incom8134-web/Kiro_wiring/images/ac.png

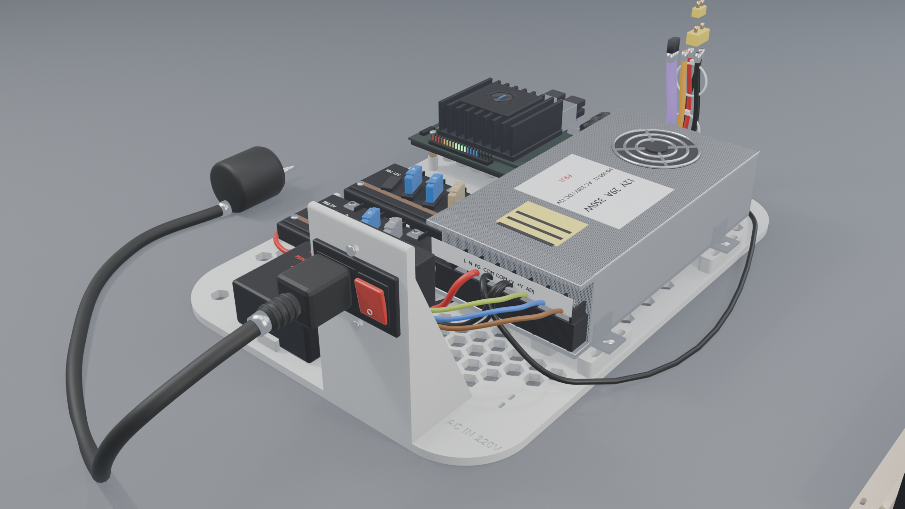
images/ac.png
