incom8134-web/Kiro_wiring/images/close.png

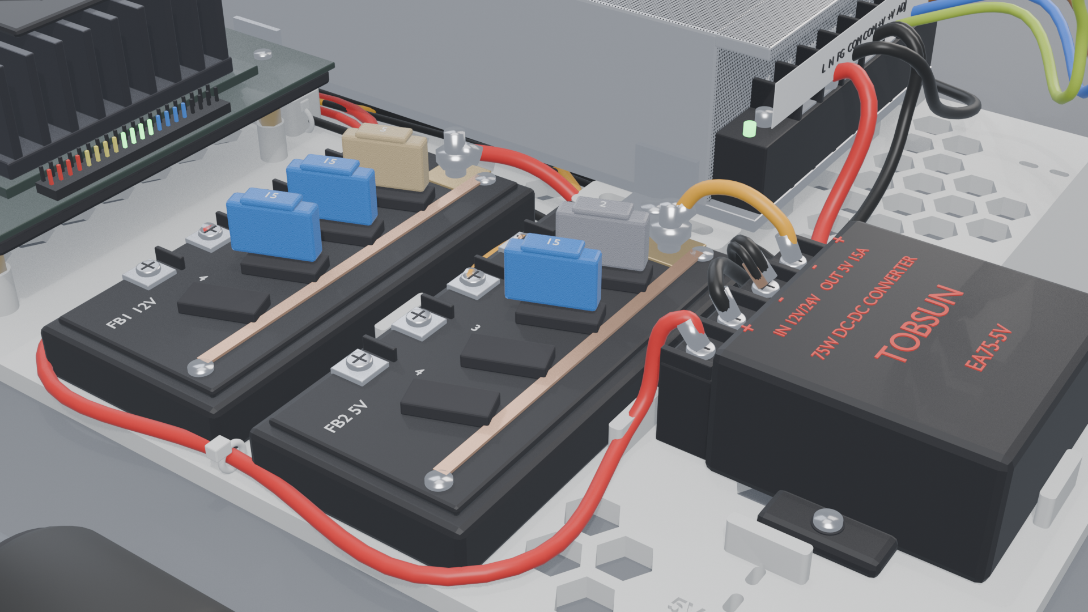
images/close.png
