incom8134-web/Kiro_wiring/images/Gemini_Generated_Image_z3li0kz3li0kz3li.png

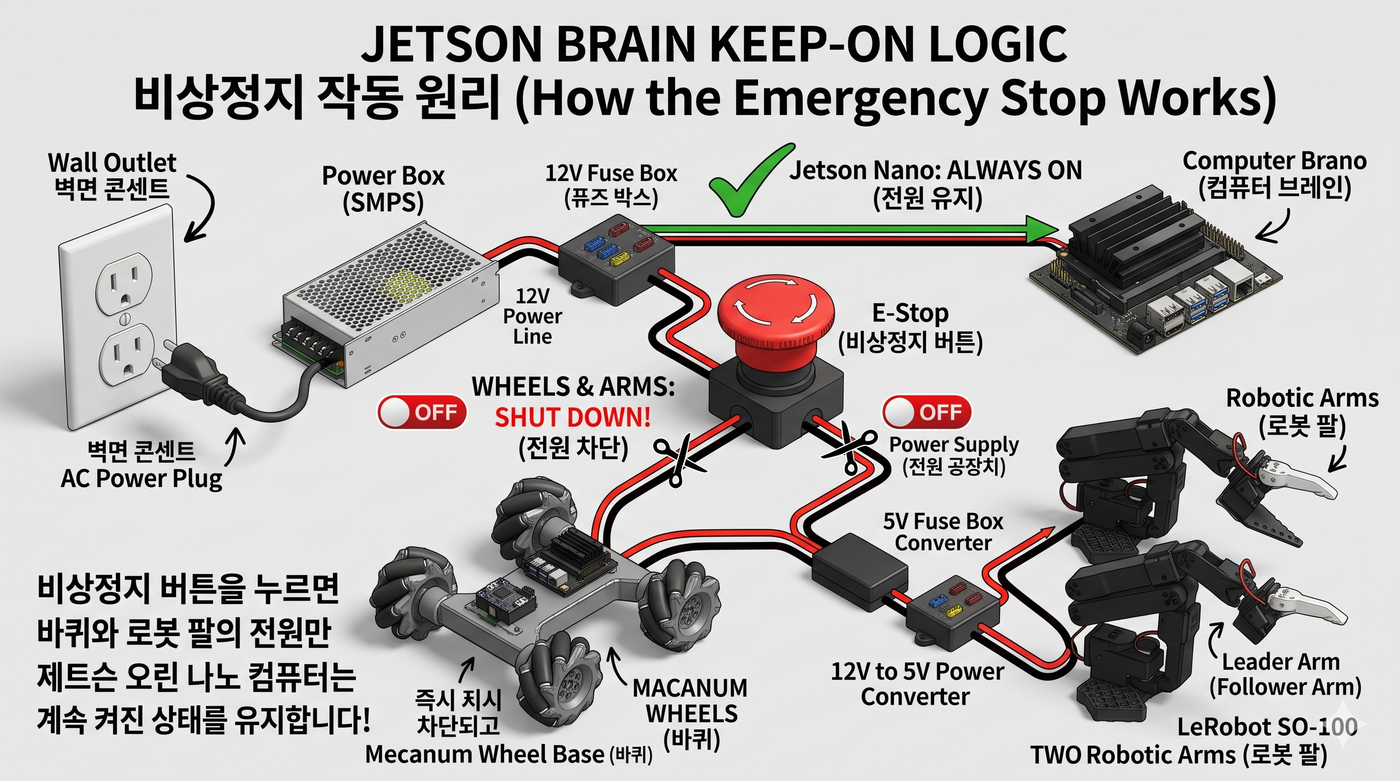
images/Gemini_Generated_Image_z3li0kz3li0kz3li.png
