incom8134-web/Kiro_wiring/images/hub.png

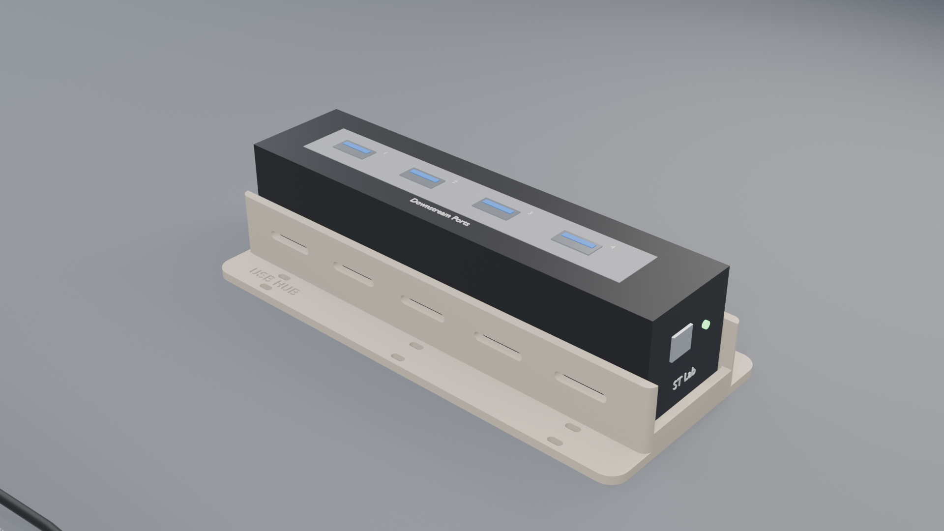
images/hub.png
