incom8134-web/Kiro_wiring/images/kiro-emergency-stop.png

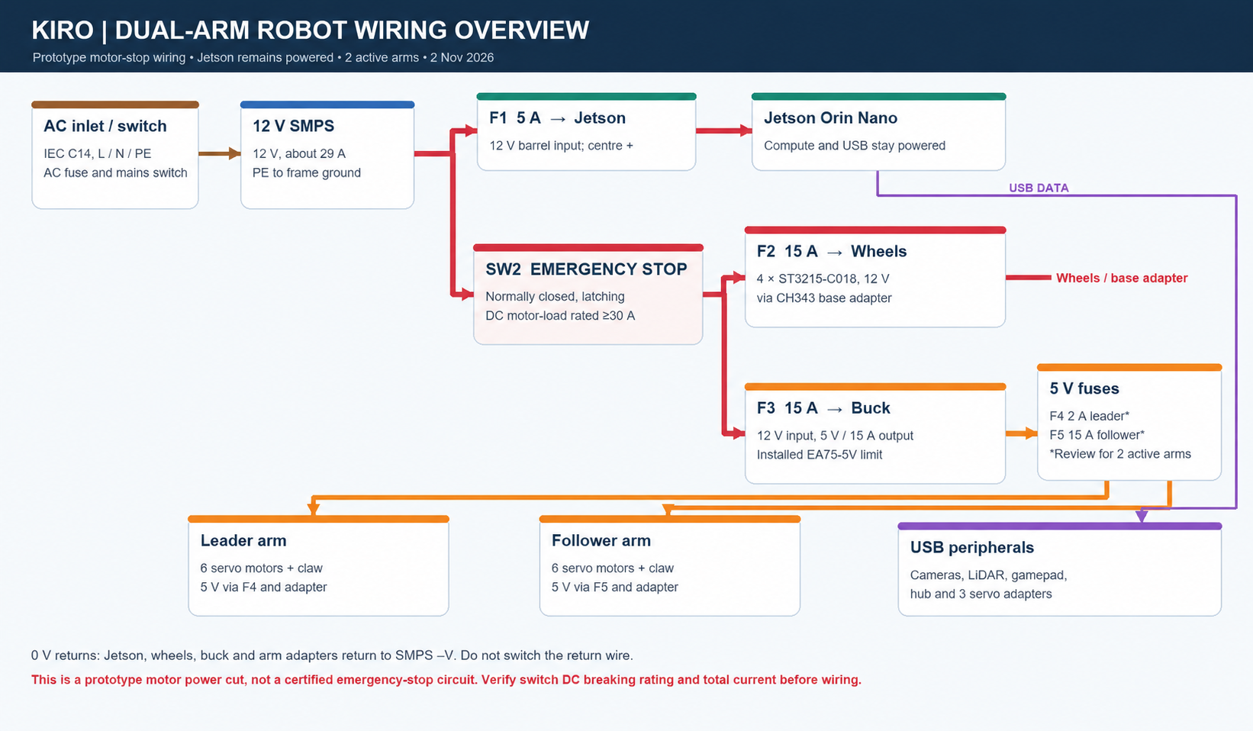
images/kiro-emergency-stop.png
