incom8134-web/Kiro_wiring/images/side.png

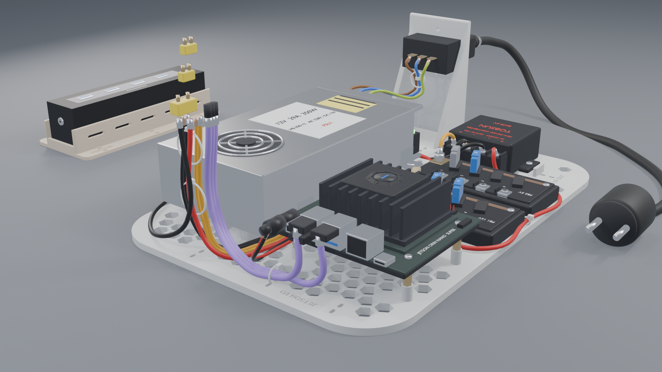
images/side.png
