incom8134-web/Kiro_wiring/images/top.png

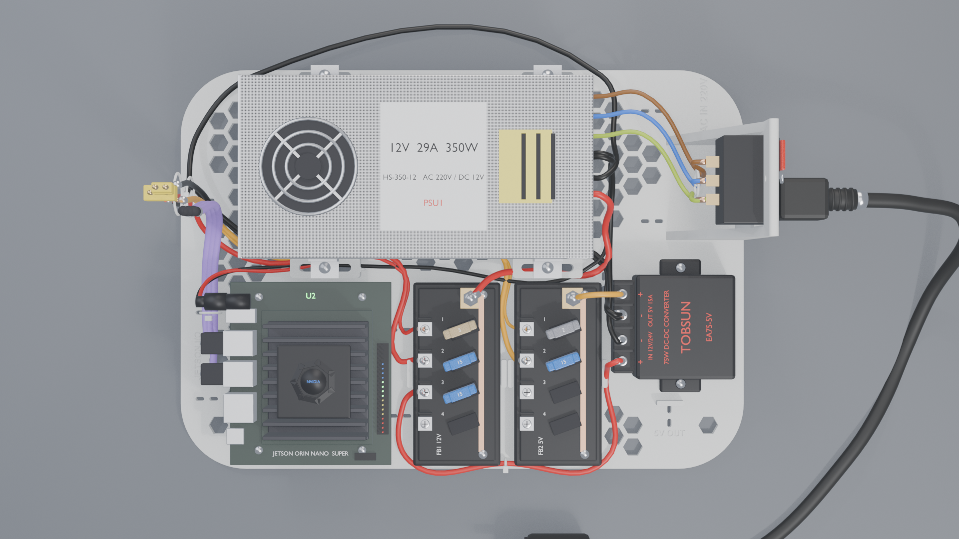
images/top.png
