incom8134-web/Kiro_wiring/kiro-wiring-2/exports/KIRO_배선도V2_BOM_261111.csv

Qty | References | Value | Library symbol | Status
1 | BT1 | LiFePO4 12.8V 45Ah (GEN) | Device:Battery | GENERIC placeholder - replace with real part
3 | C21 C22 C60 | 100nF | Device:C | specified
2 | C61 C62 | 1uF | Device:C | specified
1 | D1 | 5.0SMDJ18CA (GEN) | Device:D_TVS | GENERIC placeholder - replace with real part
1 | D2 | SMBJ18CA (verify) | Device:D_TVS | verify before purchase
2 | D60 D62 | BAT54 | Device:D_Schottky | specified
1 | D63 | 15V zener | Device:D_Zener | specified
1 | F1 | F_MAIN 40A ANL / 8AWG (GEN) | Device:Fuse | GENERIC placeholder - replace with real part
1 | F2 | F_CHG 15A (GEN) | Device:Fuse | GENERIC placeholder - replace with real part
1 | F3 | F_JETSON 5A / 18AWG | Device:Fuse | specified
1 | F4 | F_HUB 3A / 18AWG | Device:Fuse | specified
1 | F5 | F_CTRL 2A / 20AWG | Device:Fuse | specified
1 | F6 | F_DRIVE 20A / 12AWG | Device:Fuse | specified
1 | F7 | F_ARM_IN 10A / 14AWG | Device:Fuse | specified
1 | F8 | F_LEADER 2A / 20AWG | Device:Fuse | specified
1 | F9 | F_FOLLOWER 15A / 14AWG | Device:Fuse | specified
1 | F10 | F_BEACON 2A / 20AWG (GEN) | Device:Fuse | GENERIC placeholder - replace with real part
1 | J1 | J_BATT Anderson SB50 (GEN) | Connector_Generic:Conn_01x02 | GENERIC placeholder - replace with real part
1 | J2 | J_CHG XT60 charger inlet (GEN) | Connector_Generic:Conn_01x02 | GENERIC placeholder - replace with real part
1 | J60 | J_BEACON 2-pin 5A (GEN) | Connector_Generic:Conn_01x02 | GENERIC placeholder - replace with real part
1 | K1 | K1 12V DC contactor 80A + AUX NO (GEN) | KIRO_V2:Contactor_1NO_AuxNO | GENERIC placeholder - replace with real part
1 | LA1 | Red 12V LED beacon 5W (GEN) | Device:Lamp | GENERIC placeholder - replace with real part
1 | M31 | ST3215-C018 FR ID7 | KIRO_V2:Servo_ST3215 | specified
1 | M32 | ST3215-C018 FL ID8 | KIRO_V2:Servo_ST3215 | specified
1 | M33 | ST3215-C018 RR ID9 | KIRO_V2:Servo_ST3215 | specified
1 | M34 | ST3215-C018 RL ID10 | KIRO_V2:Servo_ST3215 | specified
1 | M40 | LEADER 6x STS3215 (torque off) | KIRO_V2:ServoChain_STS3215_x6 | specified
1 | M41 | FOLLOWER 6x STS3215 7.4V (GEN) | KIRO_V2:ServoChain_STS3215_x6 | GENERIC placeholder - replace with real part
1 | NT1 | carrier GND = J16 return | Device:NetTie_2 | specified
1 | Q1 | IRLZ44N (GEN) | Device:Q_NMOS | GENERIC placeholder - replace with real part
1 | Q2 | BSS138 | Transistor_FET:BSS138 | specified
2 | R1 R66 | 4k7 | Device:R | specified
1 | R21 | 1k | Device:R | specified
3 | R22 R23 R61 | 100R | Device:R | specified
3 | R24 R25 R60 | 10k | Device:R | specified
3 | R62 R63 R65 | 100k | Device:R | specified
1 | R64 | 220R | Device:R | specified
1 | S1 | 22mm mushroom twist-release 1NC (GEN) | KIRO_V2:EStop_Mushroom_NC | GENERIC placeholder - replace with real part
1 | SW1 | SW_MAIN 100A disconnect (GEN) | Switch:SW_SPST | GENERIC placeholder - replace with real part
1 | SW2 | START momentary NO | Switch:SW_Push | specified
1 | TP1 | TP_DRIVE_POWER | Connector:TestPoint | specified
1 | TP2 | TP_ARM_POWER | Connector:TestPoint | specified
1 | TP60 | TP_BEACON_ENABLE | Connector:TestPoint | specified
1 | TP61 | TP_BEACON_OUT | Connector:TestPoint | specified
1 | TP70 | TP_BATTERY_RAW | Connector:TestPoint | specified
1 | TP71 | TP_POWER_GND | Connector:TestPoint | specified
1 | TP72 | TP_COMPUTE_POWER | Connector:TestPoint | specified
1 | TP73 | TP_CTRL_12V | Connector:TestPoint | specified
1 | TP74 | TP_12V_AFTER_CONTACTOR | Connector:TestPoint | specified
1 | TP75 | TP_REGULATED_12V | Connector:TestPoint | specified
1 | TP76 | TP_ARM_LEADER_5V | Connector:TestPoint | specified
1 | TP77 | TP_ARM_FOLLOWER_5V | Connector:TestPoint | specified
1 | TP78 | TP_BEACON_12V | Connector:TestPoint | specified
1 | TP79 | TP_USB_SENSOR_5V | Connector:TestPoint | specified
1 | TP80 | TP_LOGIC_3V3 | Connector:TestPoint | specified
1 | TP81 | TP_ESTOP_OK_N | Connector:TestPoint | specified
1 | U1 | Ideal-diode LM74700 module 10A (GEN) | KIRO_V2:RevPol_IdealDiode | GENERIC placeholder - replace with real part
1 | U2 | HUB PSU 12V->5V 5A buck (GEN) | KIRO_V2:DCDC_Module | GENERIC placeholder - replace with real part
1 | U3 | REG12 12V 15A buck-boost (GEN) | KIRO_V2:DCDC_Module | GENERIC placeholder - replace with real part
1 | U4 | TOBSUN EA75-5V (8-40V in, 5V 15A) | KIRO_V2:DCDC_Module | specified
2 | U5 U61 | PC817 | Isolator:PC817 | specified
1 | U20 | Jetson Orin Nano Super Dev Kit 8GB (P3768 carrier) | KIRO_V2:Jetson_OrinNano_Super_DevKit | specified
3 | U21 U22 U60 | 74LVC1G17 | 74xGxx:74LVC1G17 | specified
1 | U30 | Bus Servo Adapter (A) CH343 - WHEELS | KIRO_V2:BusServoAdapter_A_CH343 | specified
1 | U40 | Bus Servo Adapter (A) CH343 - LEADER | KIRO_V2:BusServoAdapter_A_CH343 | specified
1 | U41 | Bus Servo Adapter (A) CH343 - FOLLOWER | KIRO_V2:BusServoAdapter_A_CH343 | specified
1 | U50 | Powered 4-port USB3 hub 5V 4A (GEN) | KIRO_V2:USB_Hub_Powered | GENERIC placeholder - replace with real part
1 | U51 | Orbbec Gemini 335 (head) | KIRO_V2:USB_Device | specified
1 | U52 | Suyin HD webcam 1e45:8022 (wrist) | KIRO_V2:USB_Device | specified
1 | U53 | Slamtec RPLIDAR C1 + CP2102N | KIRO_V2:USB_Device | specified
