incom8134-web/Kiro_wiring/3d_models/assembly.step

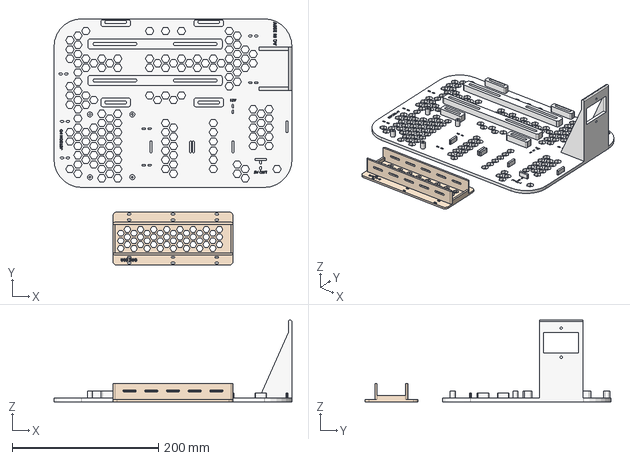
[picture p9: CAD file, 2026-10-26]
3d_models/assembly.step
326.0 x 337.5 x 112.0 mm
base_plate
usb_hub_tray
