incom8134-web/Kiro_wiring/3d_models/base_plate_left.step

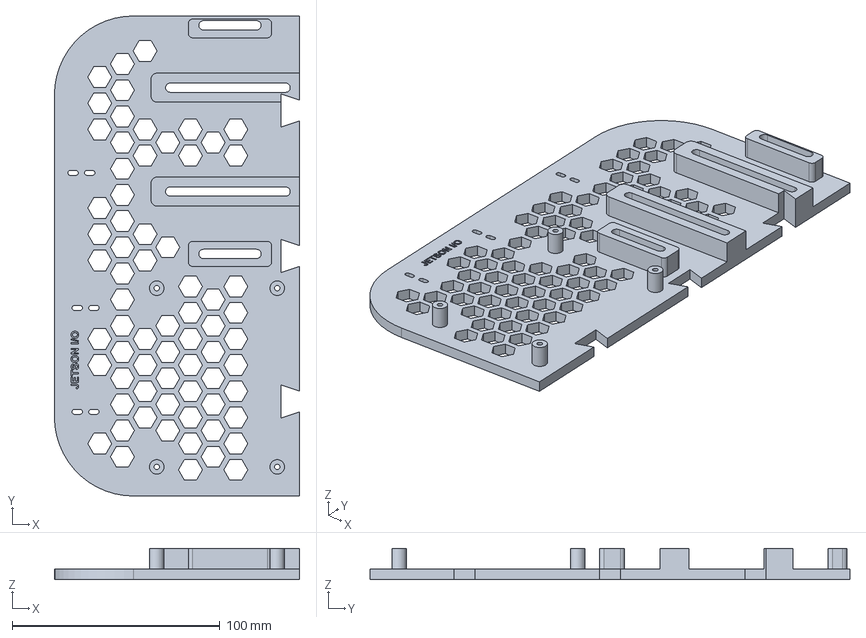
[picture p10: CAD file, 2026-10-26]
3d_models/base_plate_left.step
118.0 x 231.0 x 15.0 mm
