incom8134-web/Kiro_wiring/3d_models/usb_hub_tray.step

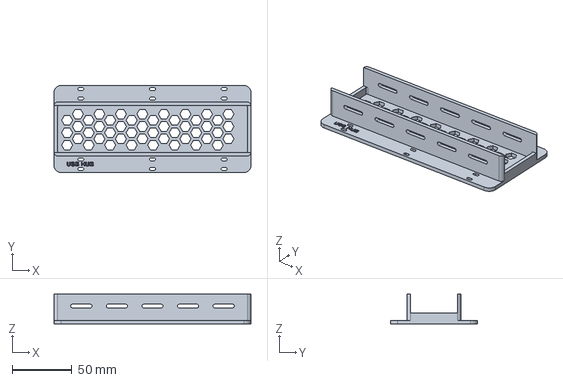
[picture p11: CAD file, 2026-10-26]
3d_models/usb_hub_tray.step
165.0 x 73.0 x 25.0 mm
