incom8134-web/Kiro_wiring/3d_models/base_plate_right.step

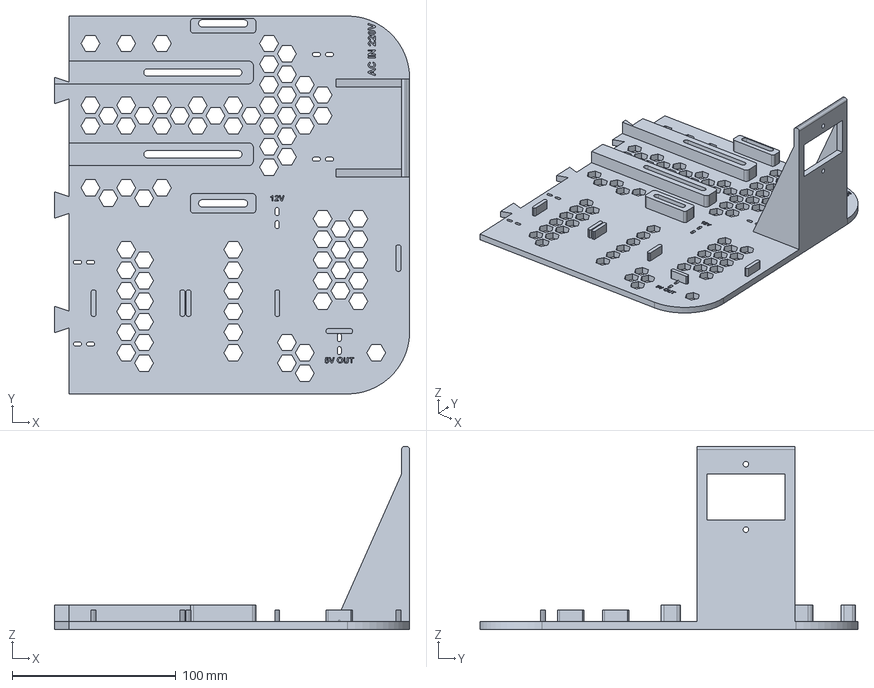
[picture p12: CAD file, 2026-10-26]
3d_models/base_plate_right.step
217.2 x 231.0 x 112.0 mm
