incom8134-web/Kiro_wiring/3d_models/base_plate.step

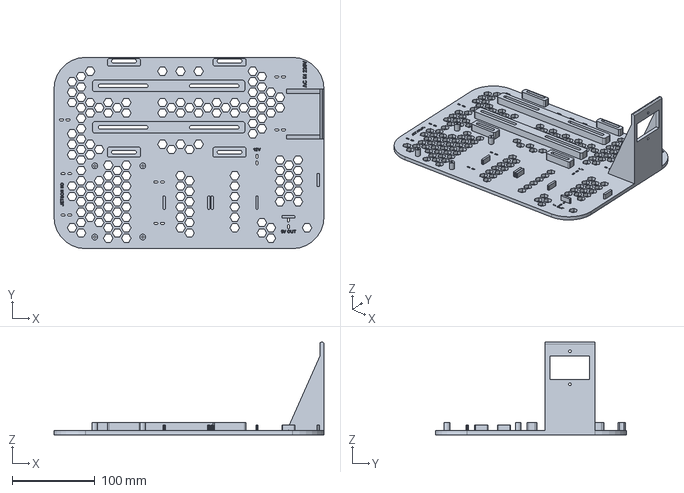
[picture p13: CAD file, 2026-10-26]
3d_models/base_plate.step
326.0 x 231.0 x 112.0 mm
