incom8134-web/Kiro_wiring/(list of files, cad)

Other CAD files:
3d_models/KIRO_power_plate.blend
3d_models/assembly.obj
3d_models/print_files/base_plate_left.3mf
3d_models/print_files/base_plate_right.3mf
3d_models/print_files/usb_hub_tray.3mf
