incom8134-web/Kiro_wiring/kiro-wiring-2/docs/KIRO_배선도V2_엔지니어링문서_261111.md

# KIRO Wiring V2 — Engineering Document (2026-11-11, rev B: generic parts)

## 0. Summary

| Item | Status |
|---|---|
| KiCad project | `kiro_wiring_v2/kiro_wiring_v2/` — root + 9 sub-sheets = **10 sheets**, **84 parts**, **74 nets** |
| KiCad ERC (10.0.7) | **0 errors / 0 warnings** |
| Connection checks | 0 unconnected pins, floating wires, orphan labels, shorted nets, symbol overlaps (all 10 sheets) |
| Cross-sheet nets | All 21 verified joined in the exported netlist |
| Visual check | All 10 sheets rendered and inspected; no overlapping or clipped text |
| V1 files | **Unchanged** (read only) |
| Part data | Real data unavailable → **18 parts are GENERIC placeholders marked `(GEN)`** on the schematic and BOM (section 15) |

Key design decisions:

1. **E-stop is a pure hard-wired self-holding loop:** mushroom NC → START (NO) ∥ K1 AUX (NO) → K1 coil. Works without software, drops out on a broken wire, no automatic restart.
2. **Jetson is upstream of K1** (COMPUTE_POWER) so it keeps running for logging and clean shutdown after an E-stop.
3. **No direct load on J12 GPIO.** NVIDIA carrier spec: J12 signals pass through TI TXB0108 translators, ±20 µA drive, pull-ups/pull-downs must be > 50 kΩ. Every GPIO uses a 74LVC1G17 buffer.
4. **Warning light fails to the warning state.** Light is ON whenever K1 is closed; it turns OFF only while the Jetson sends a ≥ 100 Hz pulse (charge-pump watchdog). Frozen, booting or crashed Jetson → light ON.
5. **REGULATED_12V is required** (LiFePO4 full charge 14.6 V > ST3215 limit 12.6 V).

---

## 1. Hardware inventory

| # | Item | Model used in V2 | Source |
|---|---|---|---|
| 1 | Battery | **LiFePO4 4S 12.8 V 45 Ah, BMS 50 A cont / 100 A peak (GEN)** | generic |
| 2 | Computer | NVIDIA Jetson Orin Nano Super Dev Kit 8 GB | V1 doc |
| 3 | Carrier | NVIDIA reference carrier (P3768): J16 DC, J12 header, J6/J7 USB | V1 doc + NVIDIA spec |
| 4 | Wheel servos | 4 × ST3215-C018 (FR 7, FL 8, RR 9, RL 10) | V1 measured |
| 5–7 | Servo adapters | 3 × Waveshare Bus Servo Adapter (A), CH343 (wheels, leader, follower) | V1 measured (USB ID) |
| 8 | "CH…" chip | **CH343**, USB 1a86:55d3 | V1 measured |
| 9 | Leader arm | 6 × STS3215, torque off | V1 doc |
| 10 | Follower arm | 6 × STS3215 **7.4 V type (GEN = same as V1)** | V1 measured |
| 11 | 5 V converter | TOBSUN EA75-5V (8–40 V in, 5 V 15 A) | V1 doc + vendor |
| 12 | USB hub | **Powered 4-port USB 3 hub, 5 V 4 A, 5.5 × 2.1 mm centre + (GEN)** | generic |
| 13 | Head camera | Orbbec Gemini 335 | V1 measured |
| 14 | Wrist camera | Suyin HD webcam 1e45:8022 (one unit) | V1 measured |
| 15 | LiDAR | Slamtec RPLIDAR C1 + CP2102N adapter | V1 measured |
| 16 | E-stop | **22 mm mushroom, twist-release, 1 NC block 11-12 (GEN)** | generic |
| 17 | Contactor | **12 V DC, 80 A main contact, AUX NO 13-14, coil ≤ 1.5 A (GEN)** | generic |
| 18 | Warning light | **Red 12 V LED beacon, 5 W (≈0.42 A), polar (GEN)** | generic |
| 19 | 12 V stabiliser | **12 V 15 A buck-boost, 8–40 V in (GEN)** | generic |
| 20 | Hub PSU | **12 V → 5 V 5 A buck (GEN)** | generic |
| 21 | Reverse-polarity stage | **LM74700-type ideal-diode module, 10 A (GEN)** | generic |

Not drawn (in V1 records, not in your brief): gamepad/keyboard dongle, head-camera servos, second arm pair.

---

## 2. Battery and voltage compatibility

| Parameter | Value used |
|---|---|
| Chemistry | LiFePO4 4S (GEN) |
| Nominal / full / minimum | 12.8 V / 14.6 V / 10.0 V (BMS cut-off) |
| BMS | 50 A continuous, 100 A peak (GEN) |
| Charger | LiFePO4 14.6 V 10 A (GEN), via XT60 inlet + F_CHG 15 A |
| Main connector | Anderson SB50, red = + (GEN) |
| Main fuse | F_MAIN 40 A ANL, 8 AWG, ≤ 150 mm from BT1+ |
| Design worst-case raw range | 10.0–14.6 V |

| Load | Allowed input | Raw battery OK? |
|---|---|---|
| Jetson J16 | 9–20 V, 5.5 × 2.5 mm, centre +, max 3.5 A (NVIDIA spec) | yes (watch current, §3) |
| EA75-5V | 8–40 V | yes |
| ST3215-C018 | 6–12.6 V (V1 trip 14.0 V) | **no** → REGULATED_12V |
| CH343 adapters | follow their servo rail (arms at 5 V as in V1) | – |
| Follower 7.4 V servos | trip 8.0 V | no → 5 V rail |
| USB hub | 5 V (GEN) | no → Hub PSU |
| Cameras, LiDAR | USB 5 V | not on battery |
| LED beacon | 12 V nominal, assumed 10–15 V (GEN) | yes, via F_BEACON after K1 |

---

## 3. Load / power table and runtime

| Branch | Typical | Design continuous | Peak | Source |
|---|---|---|---|---|
| Jetson incl. USB loads on its ports | 25 W | 36 W | 45 W | V1 doc |
| Wheels 4 × ST3215 (incl. REG12 at 92 % eff.) | 15 W | 78 W | 141 W (all four stalled, 10.8 A @ 12 V) | V1 / vendor + assumption |
| Arms via EA75 (90 % eff.) | 10 W | 31 W | 48 W | V1 doc |
| USB hub + LiDAR | 10 W | 10 W | 10 W | assumption |
| Contactor coil + beacon | 10 W | 10 W | 10 W | assumption (coil ≤ 1.5 A, beacon 5 W) |
| **Total at battery** | **≈70 W** | **≈165 W** | **≈255 W** | – |
| Current @ 12.8 V | 5.5 A | 12.9 A | 19.9 A | – |
| Current @ 10.0 V (worst) | 7.0 A | 16.5 A | 25.5 A | – |

| Runtime (estimate, LiFePO4 GEN) | Value |
|---|---|
| Nominal energy | 12.8 V × 45 Ah = 576 Wh |
| Usable (80 %) | ≈461 Wh |
| At 70 W typical | ≈6.6 h |
| At 165 W design continuous | ≈2.8 h |

| Margin | Value |
|---|---|
| BMS continuous 50 A vs 16.5 A design | 3.0 × |
| BMS peak 100 A vs 25.5 A peak | 3.9 × |
| F_MAIN 40 A vs 25.5 A peak | 1.57 × |

Assumptions: converter losses are inside the load figures; no allowance for ageing or cold. All values are estimates until the real battery and loads are measured.

**Two findings from design review**
1. **F_DRIVE raised from 15 A to 20 A / 12 AWG.** All four wheels stalled (130 W out) at 10 V input ≈ 14.1 A into REG12.
2. **Jetson J16 is rated 3.5 A.** 36 W at 10 V = 3.6 A, 45 W peak = 4.5 A. Measure input current at low battery; if > 3.5 A, add a 19 V boost converter on COMPUTE_POWER (current drops to ≈2.4 A).

---

## 4. Fuse schedule

| Fuse | Location | Rating | Wire |
|---|---|---|---|
| F1 F_MAIN | ≤ 150 mm from BT1+ | 40 A ANL (GEN) | 8 AWG |
| F2 F_CHG | charger inlet | 15 A (GEN) | 14 AWG |
| F3 F_JETSON | FB1 | 5 A | 18 AWG |
| F4 F_HUB | FB1 | 3 A | 18 AWG |
| F5 F_CTRL | FB1 → E-stop loop | 2 A | 20 AWG |
| F6 F_DRIVE | FB2 (after K1) | 20 A | 12 AWG |
| F7 F_ARM_IN | FB2 | 10 A | 14 AWG |
| F8 F_LEADER | EA75 output | 2 A | 20 AWG |
| F9 F_FOLLOWER | EA75 output | 15 A | 14 AWG |
| F10 F_BEACON | FB2 | 2 A (GEN, covers LED inrush) | 20 AWG |

Rule: fuse ≤ wire ampacity ≤ connector rating. FB1 = unswitched, FB2 = switched by K1. Use ATO/ATC blade fuses in two fuse boxes; ANL holder for F_MAIN.

---

## 5. Cable schedule (lengths are estimates – measure on the robot)

| ID | Run | Net | Wire | Est. length | Notes |
|---|---|---|---|---|---|
| W01 | BT1+ → F_MAIN → J_BATT → SW_MAIN | BATT_POS / BATTERY_RAW | 8 AWG | 0.6 m | ring lugs, strain relief |
| W02 | BT1− → star point | POWER_GND | 8 AWG | 0.3 m | all returns land here |
| W03 | FB1 → RPP → Jetson J16 | COMPUTE_POWER | 18 AWG | 0.5 m | 5.5 × 2.5 mm centre + plug |
| W04 | FB1 → Hub PSU → hub | USB_SENSOR_5V | 18 AWG | 0.5 m | 5.5 × 2.1 mm centre + (GEN) |
| W05 | FB1 → mushroom → START/AUX → K1 coil | CTRL_12V loop | 20 AWG | 1.0 m | ferrules |
| W06 | BATTERY_RAW → K1 → FB2 | 12V_AFTER_CONTACTOR | 8 AWG | 0.4 m | M6 ring lugs |
| W07 | FB2 → REG12 → wheel adapter terminal | DRIVE_POWER / REGULATED_12V | 12 AWG | 0.6 m | terminal, not DC jack |
| W08 | adapter → servo chains | WHL_BUS1/2 | factory servo leads | – | ≤ 2 servos per Molex 5264 contact |
| W09 | FB2 → EA75 | ARM_IN_F | 14 AWG | 0.4 m | |
| W10 | F_LEADER → leader adapter | ARM_LEADER_5V | 20 AWG | 0.8 m | |
| W11 | F_FOLLOWER → follower adapter | ARM_FOLLOWER_5V | 14 AWG | 0.8 m | |
| W12 | FB2 → J60 → beacon on head | BEACON_12V / BEACON_OUT | 20 AWG | 1.2 m | red = + |
| W13 | J12 1/6/29/31/7 → buffer board | logic | 26 AWG Dupont | 0.3 m | latch / glue |
| W14 | all USB | USB_* | shielded USB | – | keep away from 12 V and servo bundles |

Every adapter board returns its power through its own wire to the star point, so USB shields never carry motor current.

---

## 6. Connector and pinout schedule

| Connector | Pin | Signal | Status |
|---|---|---|---|
| J16 Jetson DC | centre / sleeve | + / − | NVIDIA spec: 5.5 × 2.5 mm, centre +, 3.5 A ✓ |
| J12 Jetson 40-pin | 1 | 3.3 V → LOGIC_3V3 | NVIDIA spec ✓ |
| | 2 | 5.0 V → LOGIC_5V, unused | ✓ |
| | 6 | GND → JETSON_LOGIC_GND | ✓ |
| | 29 | GPIO01 → BEACON_HOLDOFF_PULSE (out) | pin table ✓, boot state to measure |
| | 31 | GPIO11 ← ESTOP_OK_N (in) | same |
| | 7 | GPIO09 ← BEACON_STATE_N (in) | same |
| J6 / J7 | port 1, 2 | USB 3.2 Type-A (3 A VBUS per stack) | ✓ |
| K1 | A1/A2, 1/2, 13/14 | coil, main, AUX NO | IEC convention (GEN) |
| S1 | 11–12 | NC contact | IEC convention (GEN) |
| Servo bus | V+ / GND / DATA | Molex 5264 3-pin | use factory leads |
| Adapter VIN | + / − | screw terminal | Waveshare ✓ |
| Hub DC | centre / sleeve | + / − | 5.5 × 2.1 mm (GEN) |
| J1 J_BATT | 1 / 2 | + / − | Anderson SB50 (GEN) |
| J2 J_CHG | 1 / 2 | + / − | XT60 (GEN) |
| J60 J_BEACON | 1 / 2 | lamp + / lamp − | 2-pin 5 A (GEN) |

---

## 7. GPIO assignment and configuration

Basis: NVIDIA Jetson Orin Nano Developer Kit Carrier Board Specification — J12 signals are 3.3 V; non-I²C pins go through TI TXB0108 translators with ±20 µA drive; external pull-ups/pull-downs must be > 50 kΩ.

| Signal | J12 pin | SoC name | Dir | Circuit | Safe default |
|---|---|---|---|---|---|
| BEACON_HOLDOFF_PULSE | 29 (proposed) | GPIO01 | out | R21 1 k → U60 74LVC1G17, R63 100 k pull-down | floating/low → no pulses → **light ON** |
| ESTOP_OK_N | 31 (proposed) | GPIO11 | in | U5 PC817 → R24 10 k pull-up → U21 buffer → R22 100 Ω | broken wire → HIGH → treated as E-stop |
| BEACON_STATE_N | 7 (proposed) | GPIO09 | in | U61 PC817 → R25 10 k → U22 buffer → R23 100 Ω | broken wire → HIGH → "light not on" → motion refused |
| LOGIC_3V3 | 1 | – | power | 3 buffers, < 1 mA total | – |
| JETSON_LOGIC_GND | 6 | – | GND | NT1 shows it is the same ground as the J16 return | – |

Rules
- **No hardware PWM on pin 29.** The pulse must stop when the software stops.
- First action at boot: pin 29 = output LOW. Wheel commands are refused until then.
- Shutdown / crash handler: zero velocity → torque off → leave pin 29 LOW (light on).
- Pinmux (Jetson-IO), state during boot and after GPIO cleanup for pins 29/31/7: measure on the bench before relying on them.
- Never connect a GPIO to 12 V, the battery, the lamp, a relay/contactor coil, a motor supply or a MOSFET gate.

---

## 8. Test-point table

| TP | Net | Sheet | Expected (K1 closed) |
|---|---|---|---|
| TP70 | BATTERY_RAW | 10 | 10.0–14.6 V |
| TP71 | POWER_GND | 10 | reference (star point) |
| TP72 | COMPUTE_POWER | 10 | BATTERY_RAW − ≈0.05 V |
| TP73 | CTRL_12V | 10 | BATTERY_RAW |
| TP74 | 12V_AFTER_CONTACTOR | 10 | BATTERY_RAW (0 V when K1 open) |
| TP75 | REGULATED_12V | 10 | 12.0 V |
| TP76 / TP77 | ARM_LEADER_5V / ARM_FOLLOWER_5V | 10 | 5.0–5.2 V |
| TP78 | BEACON_12V | 10 | BATTERY_RAW |
| TP79 | USB_SENSOR_5V | 10 | 5.0–5.2 V |
| TP80 | LOGIC_3V3 | 10 | 3.3 V |
| TP81 | ESTOP_OK_N | 10 | ≈0 V K1 closed / 3.3 V K1 open |
| TP1 | DRIVE_POWER | 3 | BATTERY_RAW |
| TP2 | ARM_POWER | 3 | 5.0 V |
| TP60 | BEACON_ENABLE | 9 | < 0.5 V while pulsing / 9–13 V when stopped |
| TP61 | BEACON_OUT (lamp −) | 9 | ≈0 V lit / ≈BEACON_12V off |

---

## 9. Sequences

**Startup**
1. SW_MAIN on → Jetson boots (K1 open, no actuator power).
2. Software starts → pin 29 output LOW → wheel commands locked.
3. Release the mushroom if pressed → press START → K1 closes and self-holds.
4. Light comes on immediately → software sees ESTOP_OK_N LOW → starts the pulse → light off.
5. Servo torque on, motion allowed.

**Shutdown**
1. Stop motion, zero velocity, torque off → 2. press mushroom (K1 opens) → 3. shut down Jetson → 4. SW_MAIN off.

**Emergency stop**
1. Press mushroom → K1 opens at once → wheels, arms and light lose power; follower arm drops.
2. Jetson stays up, sees ESTOP_OK_N HIGH → commands zero, refuses motion, logs.
3. Clear the hazard → twist-release mushroom → press START deliberately → continue from startup step 4.

**Motion-warning light**

| Step | Action | Hardware |
|---|---|---|
| 1 | Non-zero wheel command received | – |
| 2 | MOTION_WARNING_REQUEST active = stop pulsing | C62 starts discharging |
| 3 | Light on; confirm BEACON_STATE_N LOW (timeout 0.5 s → refuse motion, log) | lit within ≈0.1–0.15 s (estimate) |
| 4 | Wait 0.5 s after confirmation | lit |
| 5 | Forward wheel command | lit |
| 6 | Stay lit while any command ≠ 0 | lit |
| 7 | After commands return to 0, stay lit 1.0 s | lit |
| 8 | Resume pulses → light off | – |

---

## 10. Warning-light wiring and control pseudocode

```text
Power:    12V_AFTER_CONTACTOR ─ F_BEACON 2A ─ BEACON_12V ─ J60.1 ─ beacon + … beacon − ─ J60.2 ─ Q1 D (IRLZ44N)
                                                                     Q1 S ─ POWER_GND
Gate:     BEACON_12V ─ R60 10k ─ BEACON_ENABLE ─ R61 100R ─ Q1 G ;  R62 100k + D63 15 V zener G-S
                                     └─ Q2 BSS138 drain ;  Q2 source ─ JETSON_LOGIC_GND
Watchdog: J12-29 ─ R21 1k ─ U60 74LVC1G17 ─ R64 220R ─ C61 1µF ─┬─ D60 BAT54 → GND
                                                               └─ D62 BAT54 ─ HOLDOFF_DC ─ Q2 G
                                                                   C62 1µF, R65 100k → GND (τ = 0.1 s)
Feedback: BEACON_12V ─ R66 4k7 ─ U61 LED ─ BEACON_OUT ;  U61 transistor → BEACON_STATE_N
```

Q1 rule: V_DS ≥ 30 V, I_D ≥ 3 × lamp current, R_DS(on) specified at V_GS = 10 V. IRLZ44N (55 V, 22 mΩ at 10 V, V_GS max ±16 V) is the generic choice; re-check once the lamp is measured.
Relay alternative not used: frequent switching, contact wear, and fail-to-warning is harder to achieve.

```python
# Wheel-command gate + warning light (pseudocode, 200 Hz loop)
STOPPED, ARMING, MOVING, STOPPING = range(4)
state = STOPPED; t = 0; t_conf = None; last_loop_ok = now(); holdoff_allowed = True

def boot():
    gpio_out(PIN29, LOW)               # first action; wheel commands refused before this
    start_heartbeat_thread()

def heartbeat_thread():                # separate thread, NOT hardware PWM
    while True:
        healthy = (now() - last_loop_ok) < 0.05 and holdoff_allowed
        gpio_write(PIN29, toggle() if healthy else LOW)   # >=100 Hz square wave = light off
        sleep(0.005)

def control_loop(cmd):                 # 200 Hz
    global state, t, t_conf, holdoff_allowed, last_loop_ok
    last_loop_ok = now()
    if gpio_read(PIN31_ESTOP_OK_N) == HIGH:          # E-stop or broken wire
        send_zero(); state = STOPPED; holdoff_allowed = True; log("ESTOP"); return
    moving_req = any(v != 0 for v in cmd)
    if state == STOPPED:
        send_zero()
        if moving_req: holdoff_allowed = False; t = now(); t_conf = None; state = ARMING
    elif state == ARMING:
        send_zero()
        if t_conf is None:                           # 1) wait for light confirmation
            if gpio_read(PIN7_BEACON_STATE_N) == LOW: t_conf = now()
            elif now() - t > 0.5:
                log("beacon not confirmed"); state = STOPPED; holdoff_allowed = True
        elif now() - t_conf >= 0.5: state = MOVING   # 2) 0.5 s after confirmation
    elif state == MOVING:
        if moving_req: send(cmd)
        else: send_zero(); t = now(); state = STOPPING
    elif state == STOPPING:
        send_zero()
        if moving_req: state = MOVING                # light never went off: no new wait
        elif now() - t >= 1.0: holdoff_allowed = True; state = STOPPED

def shutdown_or_crash():
    send_zero(); torque_off(); holdoff_allowed = False; gpio_write(PIN29, LOW)
```

The servo bus already reports speed (V1); it can serve as an extra ROBOT_MOVING confirmation. No encoder is added.

---

## 11. LiDAR and camera connection table

| Device | Supply | Current | Interface | Connects to | Cable / shielding |
|---|---|---|---|---|---|
| Orbbec Gemini 335 (head) | USB 5 V | ≤ 896 mA, < 6.5 W | USB 3.2 Gen1 | Jetson J6 port 1, direct (never via hub) | bundled cable |
| Suyin webcam 1e45:8022 (wrist) | USB 5 V | 500 mA | USB 2.0 | Jetson J7 port 1, direct | shielded USB |
| RPLIDAR C1 + CP2102N | USB 5 V | 230 mA typ, peak est. 400 mA | UART 460800 inside / USB outside | hub DS1 | shielded USB, away from 12 V |
| USB hub, 4-port (GEN) | 5 V 4 A DC, 5.5 × 2.1 mm centre + | ≈1.5 A loaded (est.) | USB 3 | Jetson J6 port 2 | – |

LiDAR start-up (V1 rule): connect the sensor cable to its adapter with USB unplugged, then connect USB; the motor spins up when the host opens the port.

---

## 12. Bring-up checklist

1. ☐ All fuses removed. Check battery connector polarity with a meter.
2. ☐ Fit F_MAIN and F_CTRL only. Check star-point resistance.
3. ☐ E-stop loop test (no load fuses):
   - START → K1 pulls in and holds ☐ / mushroom → opens at once ☐ / releasing mushroom does not re-close ☐
   - Pull one loop wire → opens ☐ / remove F_CTRL → opens ☐ / TP74 = 0 V ☐
4. ☐ Fit F_JETSON → check TP72 → boot Jetson. **Measure J16 input current at 10–10.5 V.**
5. ☐ Connect buffer board → TP80 = 3.3 V; TP81 LOW with K1 closed, HIGH with K1 open.
6. ☐ Scope pins 29/31/7 during boot and after GPIO cleanup; record.
7. ☐ Measure beacon current at 12.0 V and 14.6 V; confirm F_BEACON 2 A and IRLZ44N are adequate.
8. ☐ Run the warning-light test (section 13).
9. ☐ Fit F_HUB → hub, LiDAR and three CH343 adapters enumerate.
10. ☐ Fit F_ARM_IN, F_LEADER, F_FOLLOWER → TP2/TP76/TP77 = 5 V → arm torque test.
11. ☐ Fit F_DRIVE → TP75 = 12 V no-load and loaded → wheel IDs 7–10 respond → slow drive test.
12. ☐ Repeat the E-stop test while driving; check the log.

## 13. Warning-light test procedure

| # | Condition | Expected | Measure at |
|---|---|---|---|
| 1 | K1 closed, Jetson off | light ON | TP61 ≈ 0 V |
| 2 | Jetson booting | light ON | TP60 9–13 V |
| 3 | Software running, robot stopped | light OFF (pin 29 ≥ 100 Hz) | TP60 < 0.5 V |
| 4 | Send wheel command | light ON within 0.15 s; wheels move ≥ 0.5 s after confirmation | pin 29 stop → TP61 fall → wheel start |
| 5 | Command back to 0 | light OFF after 1.0 s | – |
| 6 | Freeze software (`kill -STOP`) | light ON within 0.15 s | – |
| 7 | Force pin 29 HIGH (DC) | light ON (DC cannot pass the pump) | – |
| 8 | Unplug BEACON_STATE_N | software refuses motion, logs | – |
| 9 | Press mushroom | light OFF (power cut), ESTOP logged | TP78 = 0 V |

## 14. ERC report and intentional items

- KiCad 10.0.7 ERC: **0 errors, 0 warnings** (`exports/KIRO_배선도V2_ERC결과_261111.json`).
- Intentional:
  - `#FLG01–08` PWR_FLAG: ERC drive markers on rails that enter through a passive fuse. Not physical parts.
  - No-connect pins: Jetson J12-2 (5 V), J7 port 2, J5, J15, J20, J21, J14; 74LVC1G17 NC pins; BUS2 of both arm adapters.
  - NT1 net tie: J12 GND and the J16 return are the same carrier-board ground (no extra wire).
  - Pin names show `_` instead of spaces (KiCad/Konnect convention).
  - KiCad title-block "Title" field is empty (Konnect cannot set it); each sheet carries its own title text.

## 15. Generic placeholders to replace later

When you have the real part, send the label photo or model number and I will update the value, fuse and wire in one pass.

| # | Ref | Generic value now | What to send me |
|---|---|---|---|
| 1 | BT1 | LiFePO4 12.8 V 45 Ah, BMS 50/100 A | battery label |
| 2 | F1 | 40 A ANL, 8 AWG | (follows battery/BMS) |
| 3 | J1 | Anderson SB50 | photo of battery connector |
| 4 | J2 / F2 | XT60 / 15 A | charger label |
| 5 | SW1 | 100 A disconnect | switch model |
| 6 | K1 | 12 V DC contactor 80 A + AUX NO, coil ≤ 1.5 A | contactor label |
| 7 | S1 | 22 mm mushroom, 1 NC | photo of the back |
| 8 | D2 | SMBJ18CA coil TVS | (follows K1 coil) |
| 9 | D1 | 5.0SMDJ18CA bus TVS | (follows battery chemistry) |
| 10 | LA1 | red 12 V LED beacon 5 W | measured current at 12 V and full charge |
| 11 | F10 / Q1 / J60 | 2 A / IRLZ44N / 2-pin 5 A | (follows LA1) |
| 12 | U50 | 4-port USB 3 hub, 5 V 4 A, 5.5 × 2.1 mm centre + | hub + adapter label |
| 13 | U2 / F4 | 12 → 5 V 5 A buck / 3 A | (follows hub) |
| 14 | U3 | 12 V 15 A buck-boost REG12 | your chosen module |
| 15 | U1 | LM74700-type ideal diode 10 A | your chosen module |
| 16 | M41 | follower STS3215 7.4 V type | confirm servo type |
| 17 | Jetson J16 current | (measurement) | current at 10 V |
| 18 | J12 pins 29/31/7 | proposed | bench measurement of boot / cleanup state |

## 16. Sources

- NVIDIA Jetson Orin Nano Dev Kit hardware layout: https://docs.nvidia.com/jetson/orin-nano-devkit/user-guide/latest/hardware_layout.html
- NVIDIA Jetson Orin Nano Developer Kit Carrier Board Specification (copy): https://uelectronics.com/wp-content/uploads/2023/05/Jetson-Orin-Nano-DevKit-Carrier-Board-Specification.pdf — J12/J16/J14 pins, TXB0108, ±20 µA, > 50 kΩ
- Waveshare ST3215: https://waveshare.com/wiki/ST3215_Servo
- Waveshare Bus Servo Adapter (A): https://waveshare.com/wiki/Bus_Servo_Adapter_(A)
- TOBSUN 12/24 V → 5 V 15 A: https://www.newegg.com/p/2VH-02NC-002K1
- V1 records: `docs/power_system_design.md`, `docs/parts_list.md`, `_local/project_context.md`, `kiro_wiring_v2/docs/KIRO_V2_design_basis.md`
