incom8134-web/Kiro_wiring/images/base_plate_print.png

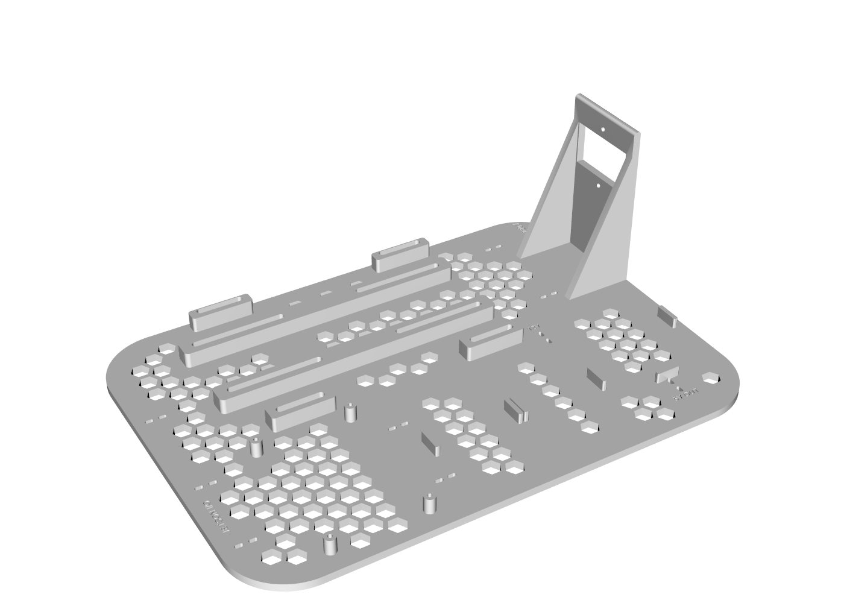
images/base_plate_print.png
