incom8134-web/Kiro_wiring/images/concept_wiring_2026-10-26.jpeg

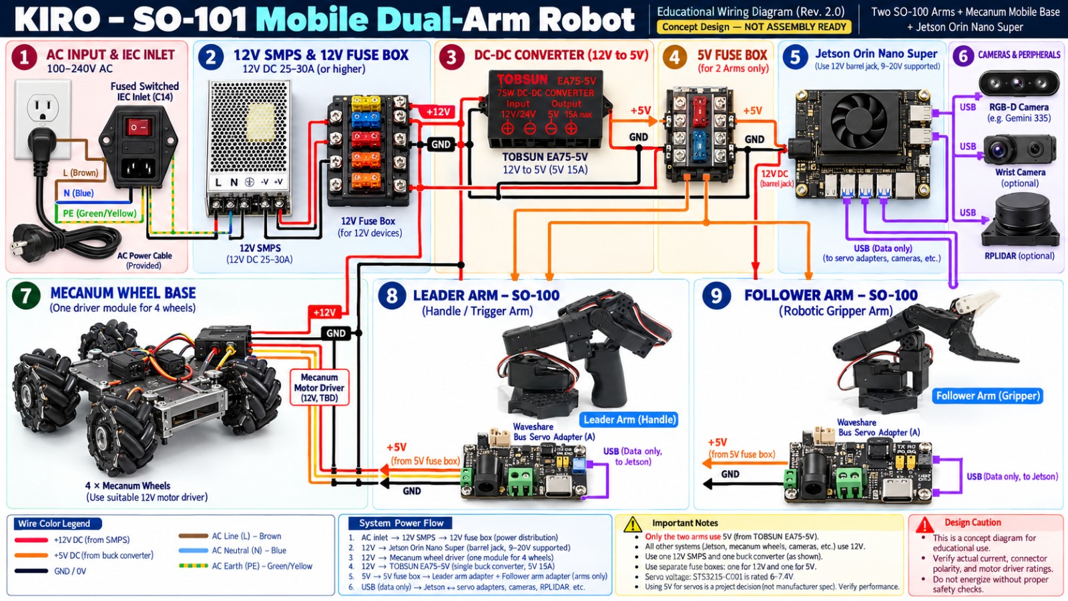
images/concept_wiring_2026-10-26.jpeg
