incom8134-web/Kiro_wiring/images/haebot_wiring_rev3_2026_11_02_kr.png

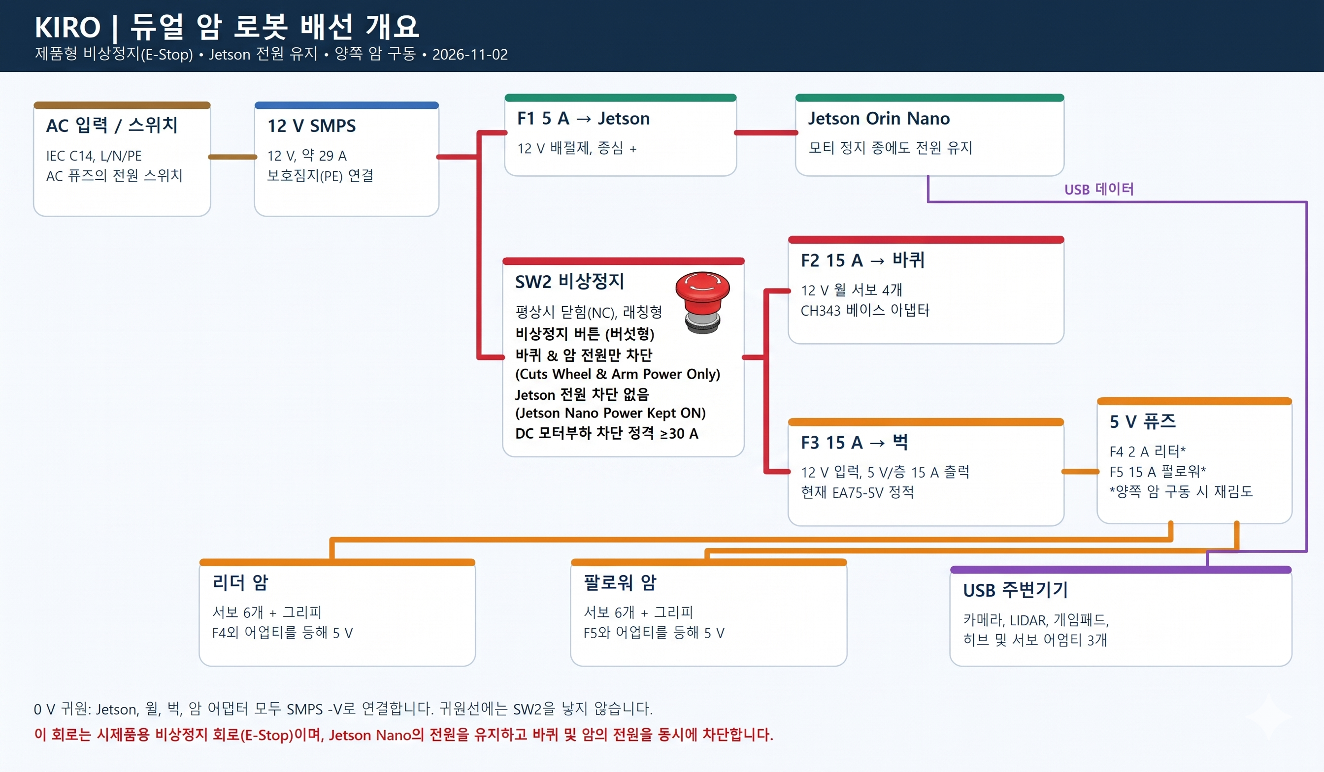
images/haebot_wiring_rev3_2026_11_02_kr.png
