incom8134-web/Kiro_wiring/images/KIRO Dual-Arm Robot Wiring Diagram.png

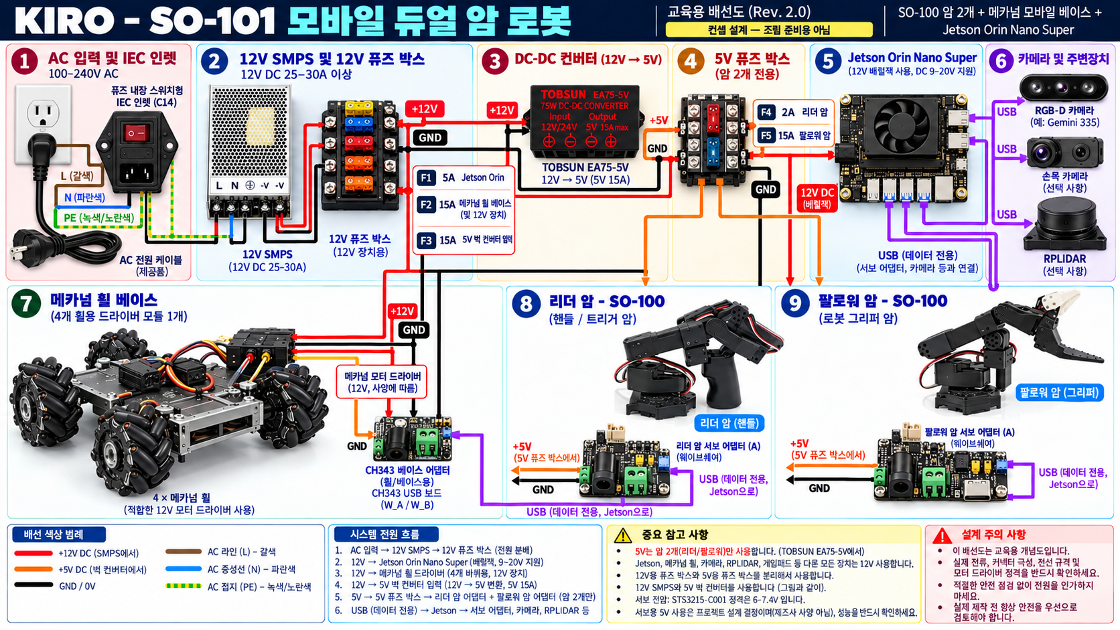
images/KIRO Dual-Arm Robot Wiring Diagram.png
