incom8134-web/Kiro_wiring/images/KIRO Robot Electrical Wiring Diagram.png

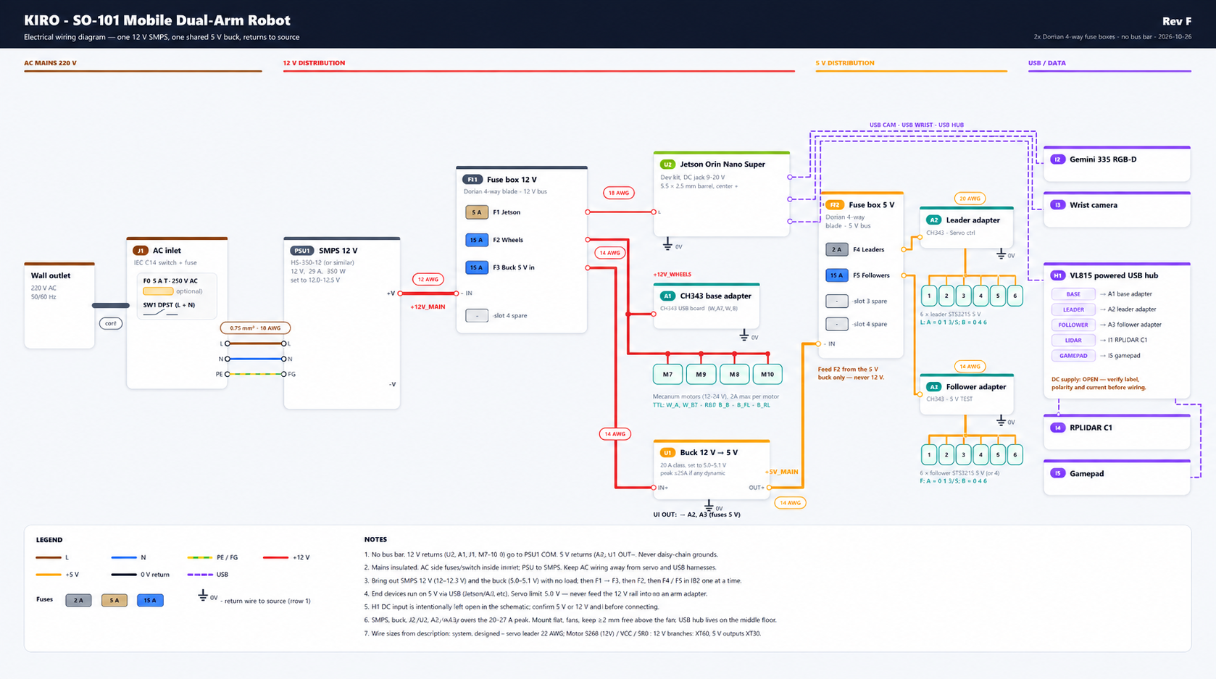
images/KIRO Robot Electrical Wiring Diagram.png
