incom8134-web/Kiro_wiring/images/Korean Robot Power Distribution Wiring Diagram.png

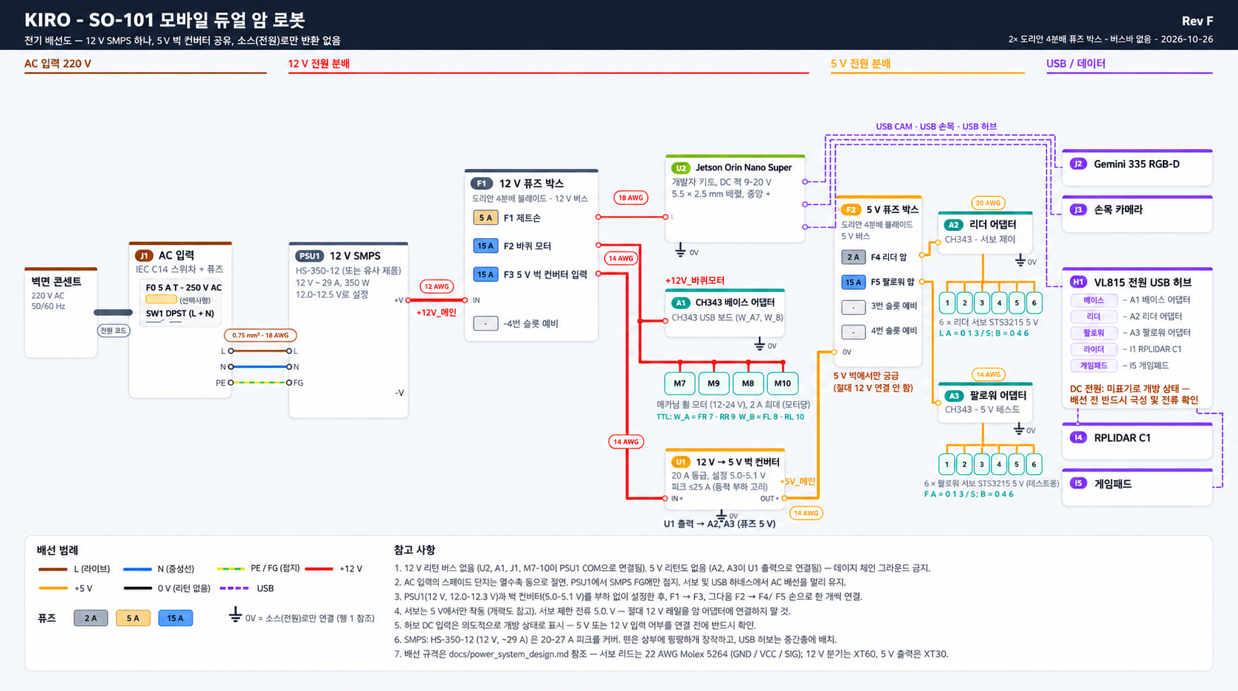
images/Korean Robot Power Distribution Wiring Diagram.png
