incom8134-web/Kiro_wiring/kiro-wiring-2/exports/png/KIRO_배선도V2_01_시스템개요_261111.png

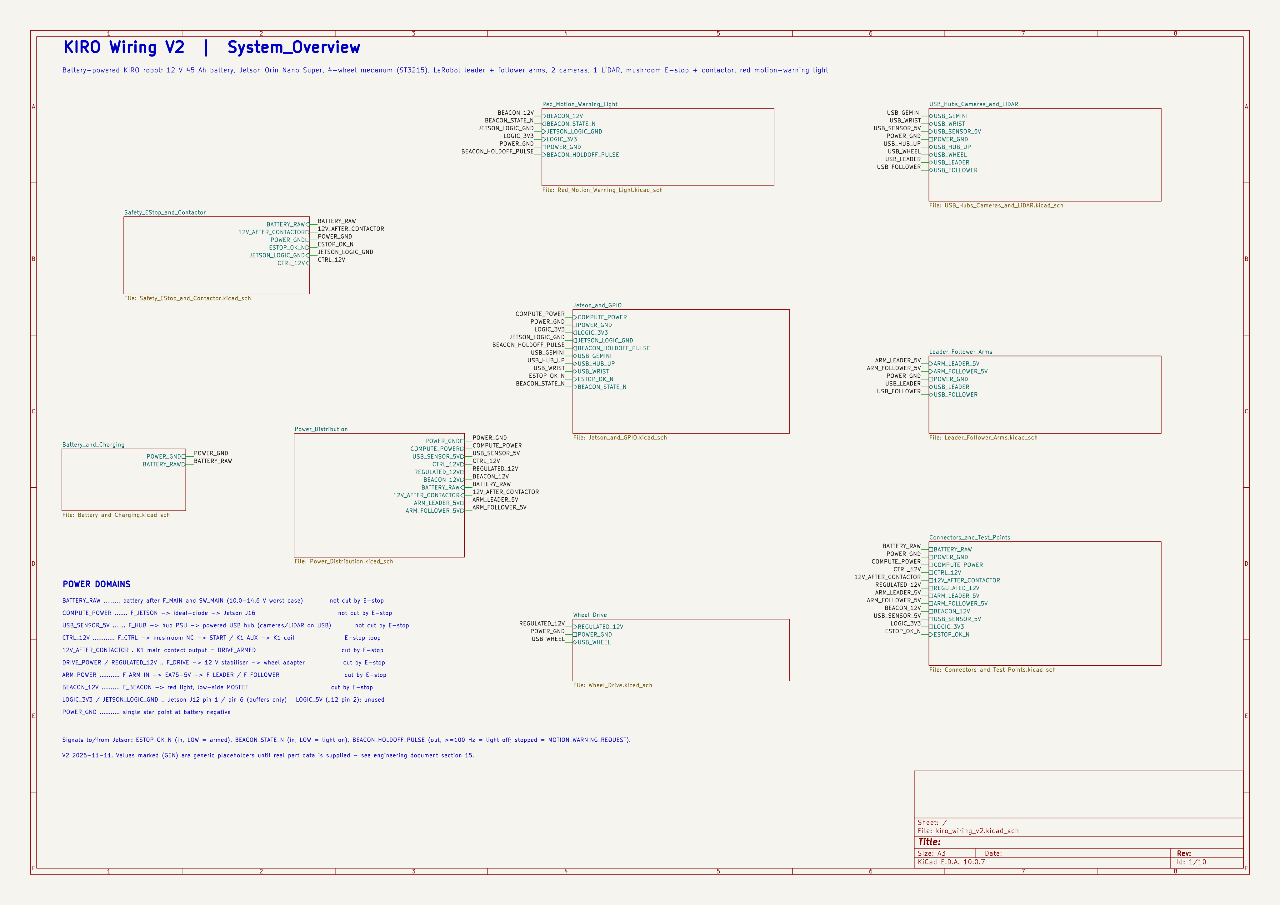
kiro-wiring-2/exports/png/KIRO_배선도V2_01_시스템개요_261111.png
