incom8134-web/Kiro_wiring/kiro-wiring-2/exports/png/KIRO_배선도V2_03_전원분배_261111.png

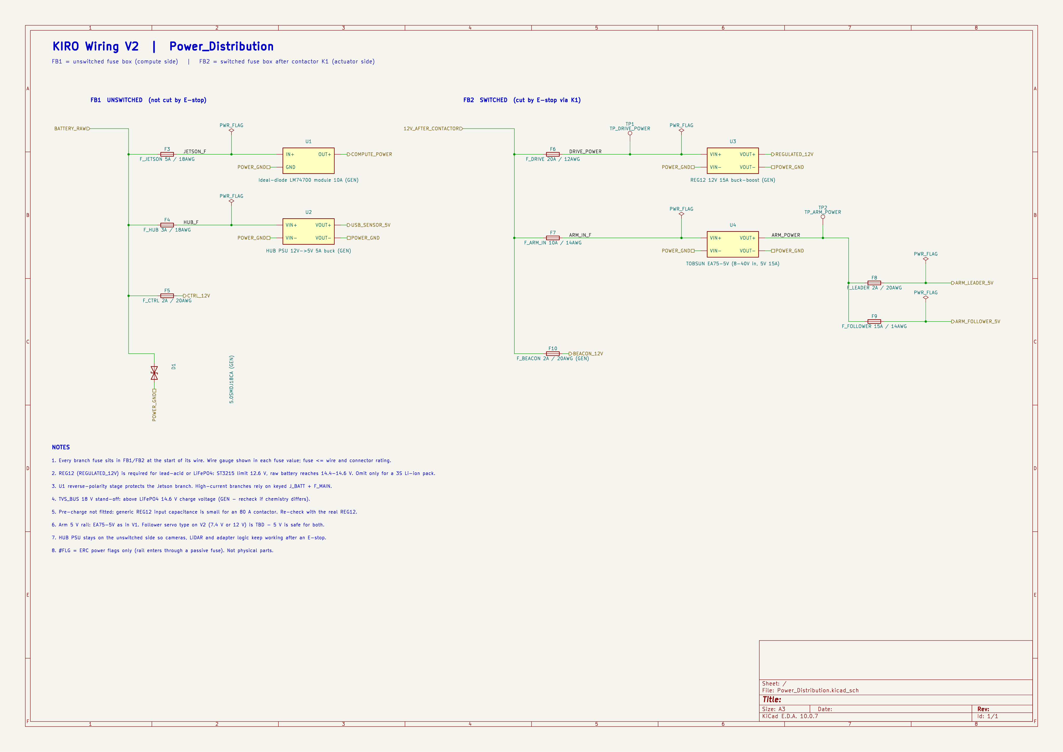
kiro-wiring-2/exports/png/KIRO_배선도V2_03_전원분배_261111.png
