incom8134-web/Kiro_wiring/kiro-wiring-2/exports/png/KIRO_배선도V2_04_비상정지접촉기_261111.png

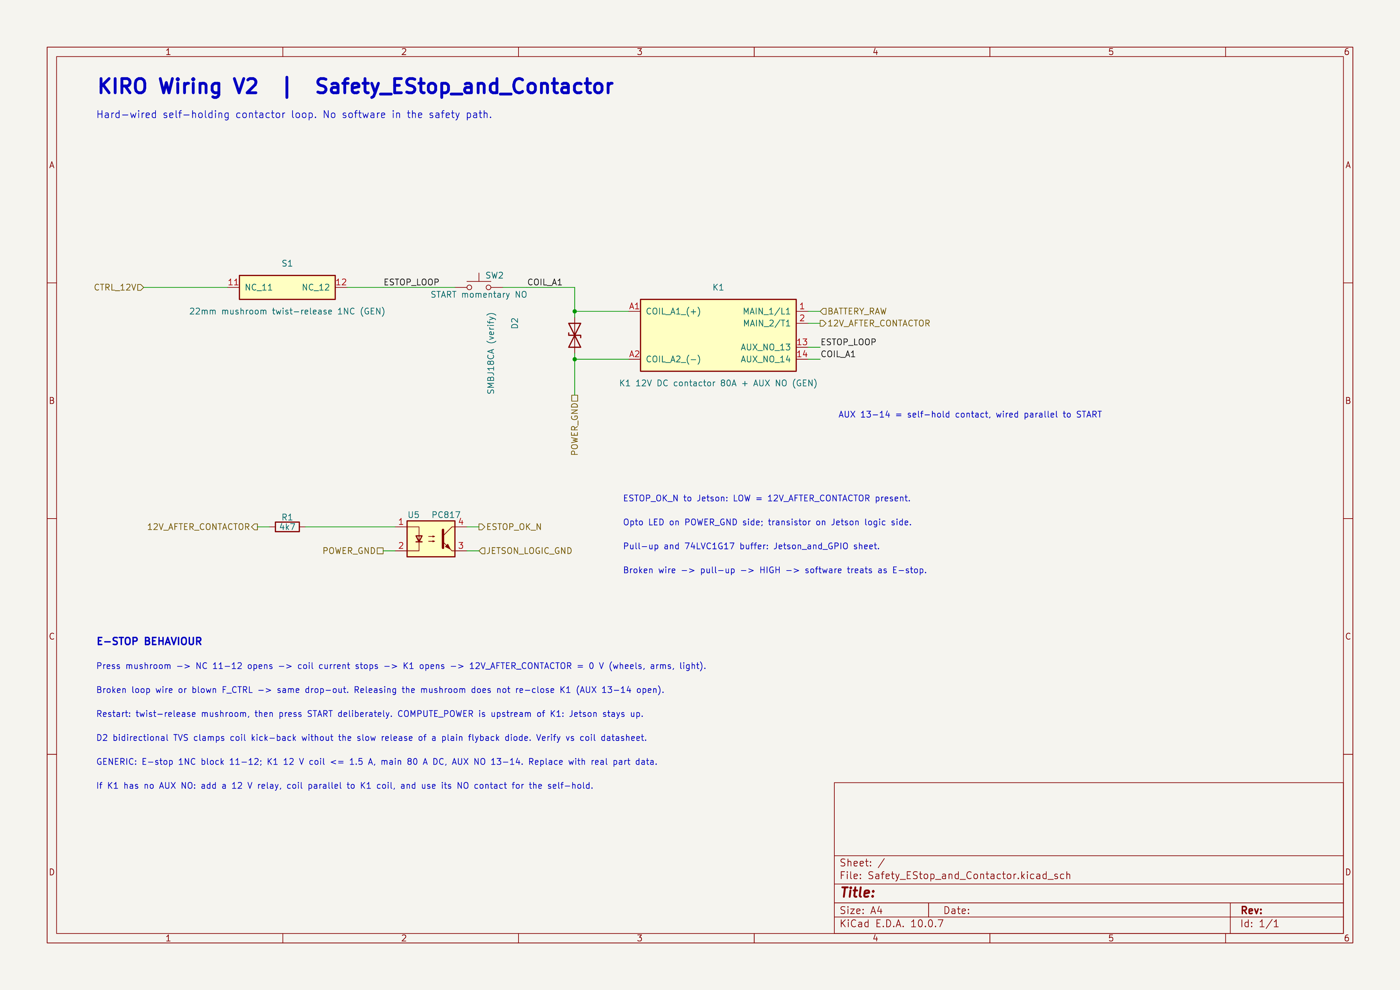
kiro-wiring-2/exports/png/KIRO_배선도V2_04_비상정지접촉기_261111.png
