incom8134-web/Kiro_wiring/kiro-wiring-2/exports/png/KIRO_배선도V2_08_USB허브카메라라이다_261111.png

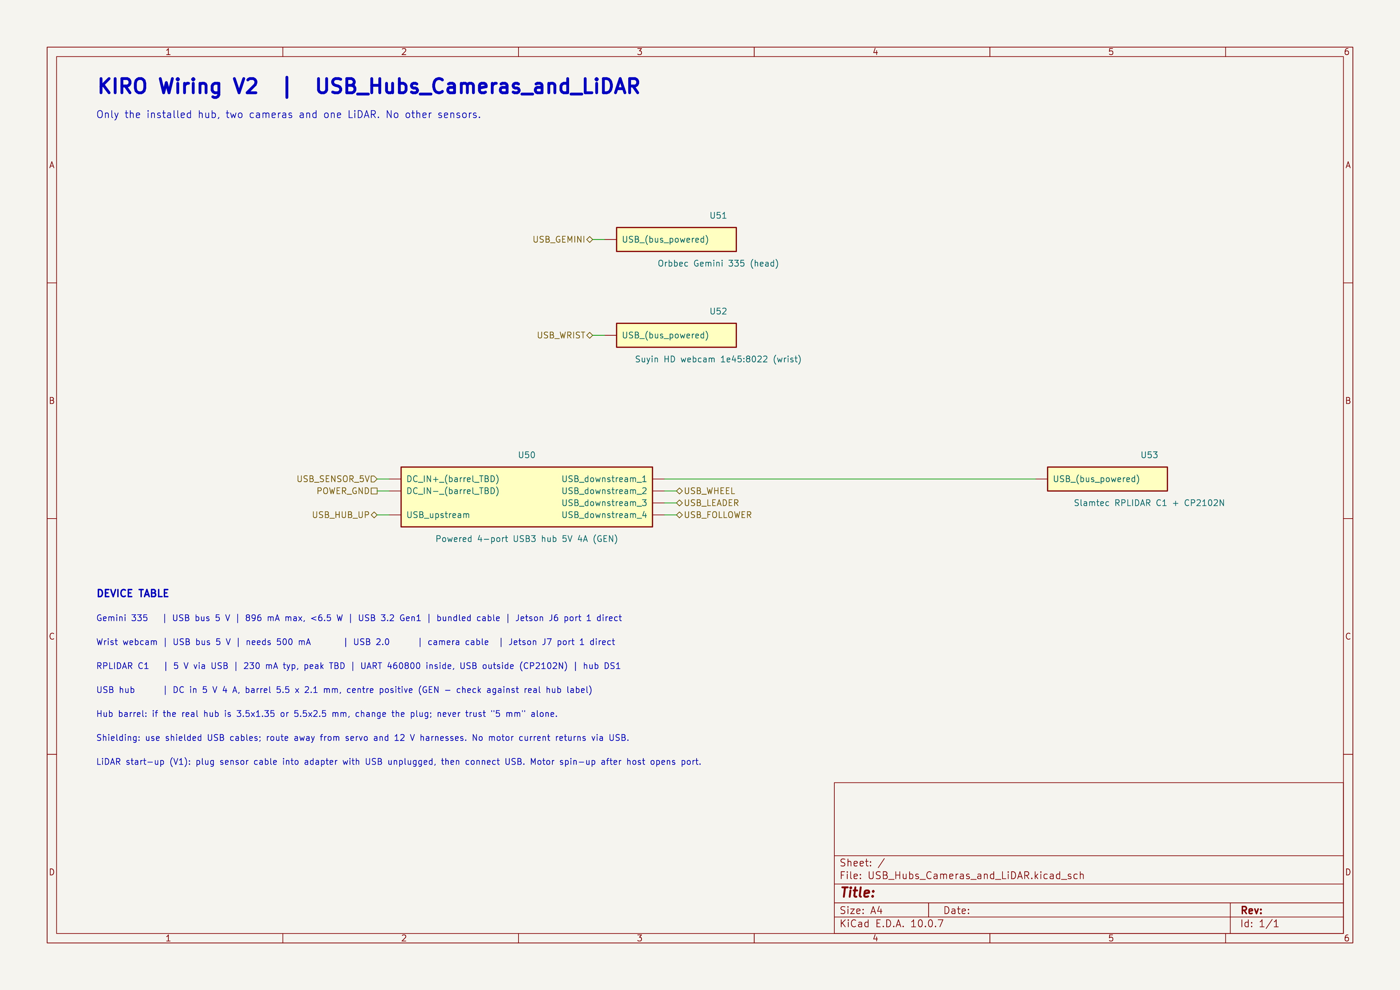
kiro-wiring-2/exports/png/KIRO_배선도V2_08_USB허브카메라라이다_261111.png
