incom8134-web/Kiro_wiring/kiro-wiring-2/exports/png/KIRO_배선도V2_10_커넥터테스트포인트_261111.png

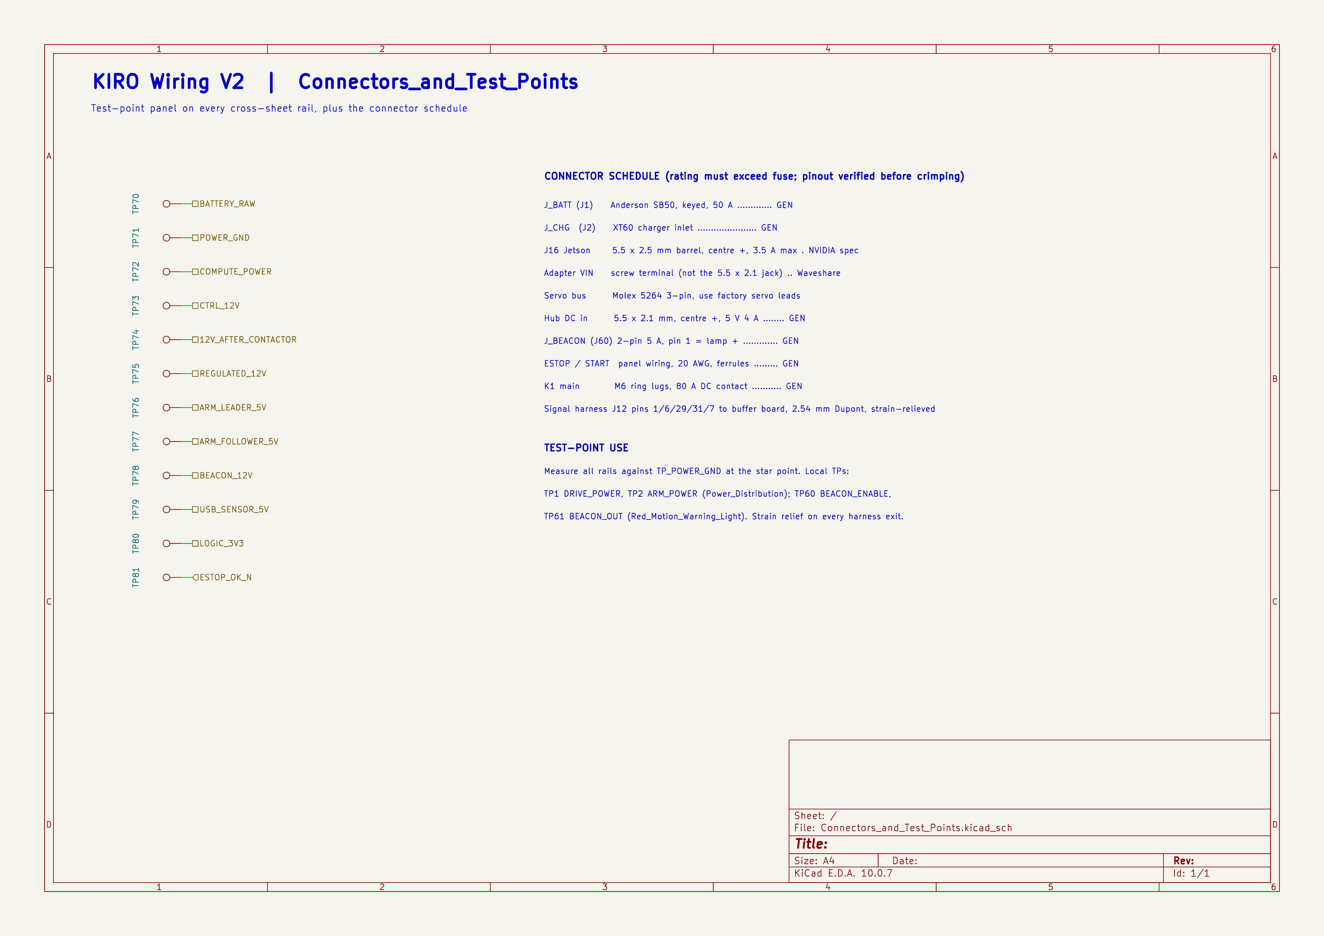
kiro-wiring-2/exports/png/KIRO_배선도V2_10_커넥터테스트포인트_261111.png
