incom8134-web/Kiro_wiring/kiro-wiring-2/anker-solix-battery-haebot/exports/HAEBOT_ANKER_BLOCK_DIAGRAM_KO.pdf

# HAEBOT / KIRO V2-A 앤커 솔릭스 C300 DC 전원 블록 다이어그램

Rev B, 2026-11-13. 제안 단계 설계, 실측 검증 전. 포트 한계: 앤커 A1726 사용 설명서, 부하: V1 Rev F 기록.

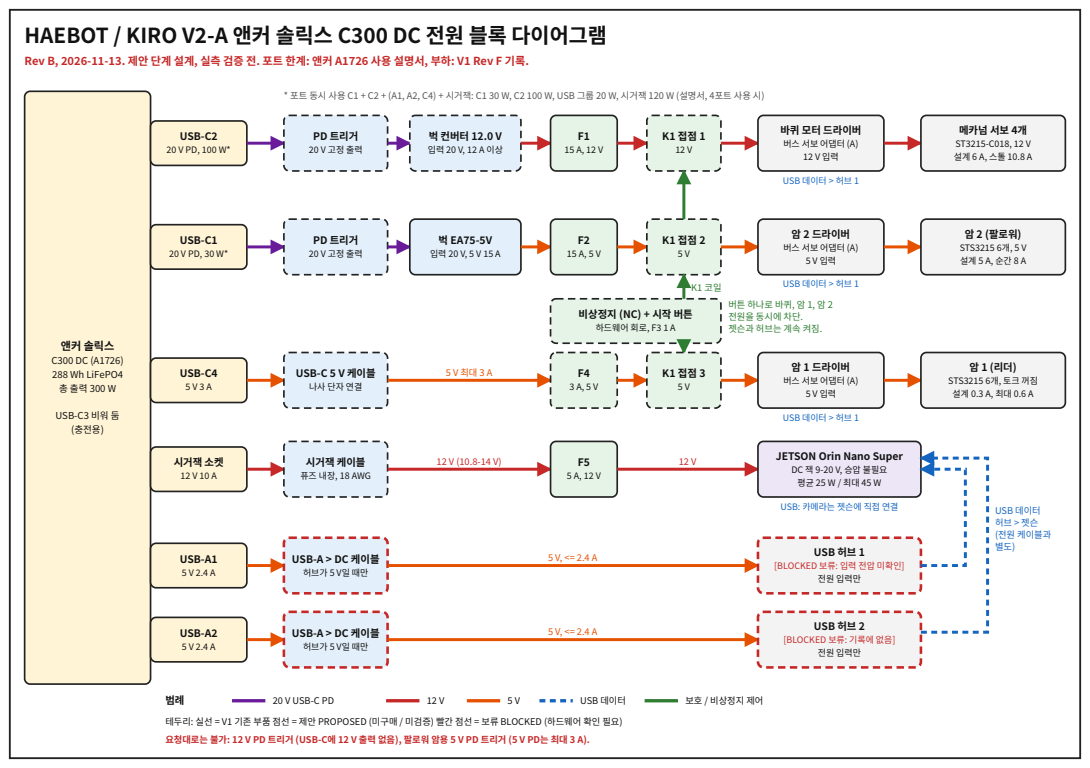
[picture p36: page 1]
앤커 솔릭스 C300 DC (A1726) 288 Wh LiFePO4 총 출력 300 W; USB-C3 비워 둠 (충전용); USB-C2 20 V PD, 100 W*; USB-C1 20 V PD, 30 W*; USB-C4 5 V 3 A; 시거잭 소켓 12 V 10 A; USB-A1 5 V 2.4 A; USB-A2 5 V 2.4 A; PD 트리거 20 V 고정 출력; 벅 컨버터 12.0 V 입력 20 V, 12 A 이상; 메카넘 서보 4개 ST3215-C018, 12 V 설계 6 A, 스톨 10.8 A; 암 2 (팔로워) STS3215 6개, 5 V 설계 5 A, 순간 8 A; 암 1 (리더) STS3215 6개, 토크 꺼짐 설계 0.3 A, 최대 0.6 A; JETSON Orin Nano Super; USB 허브 1; 전원 입력만; USB 허브 2; USB 데이터 허브 > 젯슨 (전원 케이블과 별도); 20 V USB-C PD; USB 데이터; 보호 / 비상정지 제어

* 포트 동시 사용 C1 + C2 + (A1, A2, C4) + 시거잭: C1 30 W, C2 100 W, USB 그룹 20 W, 시거잭 120 W (설명서, 4포트 사용 시)

바퀴 모터 드라이버
버스 서보 어댑터 (A)
USB 데이터 > 허브 1

암 2 드라이버

버튼 하나로 바퀴, 암 1, 암 2
전원을 동시에 차단.
젯슨과 허브는 계속 켜짐.

비상정지 (NC) + 시작 버튼
하드웨어 회로, F3 1 A

USB-C 5 V 케이블

암 1 드라이버

시거잭 케이블
퓨즈 내장, 18 AWG

DC 잭 9-20 V, 승압 불필요
USB: 카메라는 젯슨에 직접 연결

USB-A > DC 케이블
허브가 5 V일 때만

[BLOCKED 보류: 입력 전압 미확인]

[BLOCKED 보류: 기록에 없음]
전원 입력만

테두리: 실선 = V1 기존 부품 점선 = 제안 PROPOSED (미구매 / 미검증) 빨간 점선 = 보류 BLOCKED (하드웨어 확인 필요)
요청대로는 불가: 12 V PD 트리거 (USB-C에 12 V 출력 없음), 팔로워 암용 5 V PD 트리거 (5 V PD는 최대 3 A).
