incom8134-web/Kiro_wiring/kiro-wiring-2/ev-battery-haebot/exports/HAEBOT_EV_BLOCK_DIAGRAM_KO.pdf

# HAEBOT / KIRO V2-B 12 V 45 Ah EV 배터리 전원 블록 다이어그램

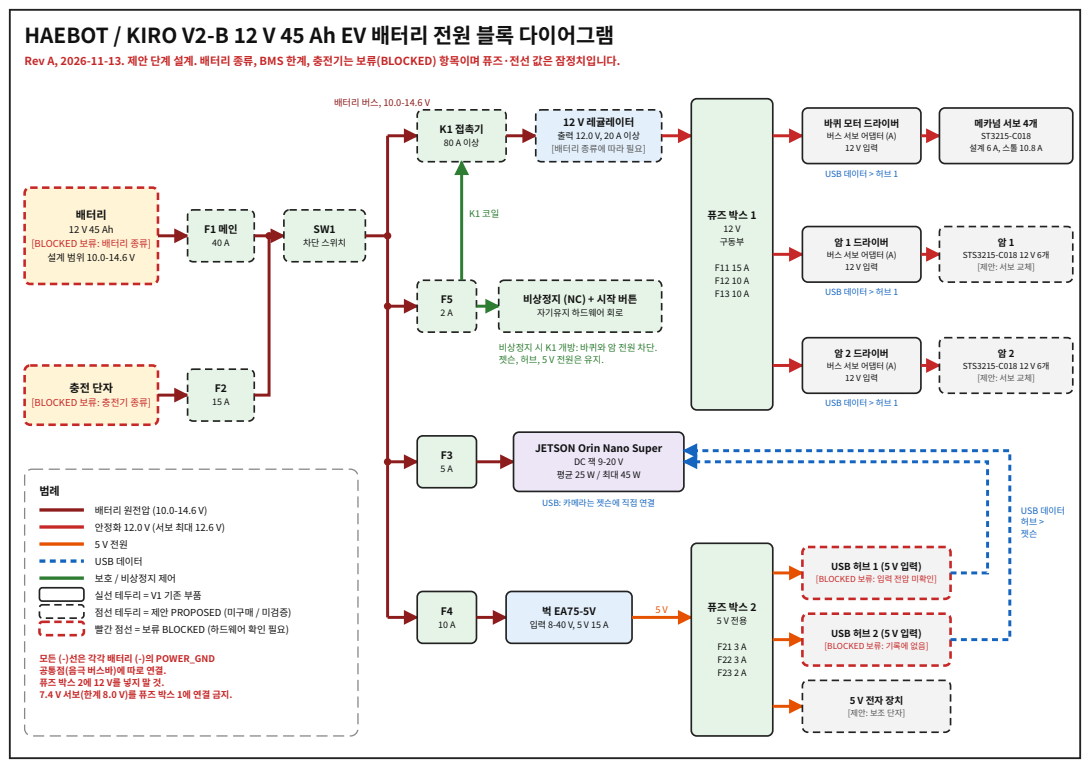
[picture p37: page 1]
SW1 차단 스위치; 배터리 버스, 10.0-14.6 V; K1 접촉기 80 A 이상; 퓨즈 박스 1 12 V 구동부; 메카넘 서보 4개 ST3215-C018 설계 6 A, 스톨 10.8 A; 암 1 STS3215-C018 12 V 6개 [제안: 서보 교체]; 암 2 STS3215-C018 12 V 6개 [제안: 서보 교체]; USB 데이터 허브 > 젯슨

Rev A, 2026-11-13. 제안 단계 설계. 배터리 종류, BMS 한계, 충전기는 보류(BLOCKED) 항목이며 퓨즈·전선 값은 잠정치입니다.

12 V 레귤레이터
[배터리 종류에 따라 필요]

바퀴 모터 드라이버
버스 서보 어댑터 (A)

USB 데이터 > 허브 1

배터리
[BLOCKED 보류: 배터리 종류]

암 1 드라이버

비상정지 (NC) + 시작 버튼
자기유지 하드웨어 회로

비상정지 시 K1 개방: 바퀴와 암 전원 차단.
젯슨, 허브, 5 V 전원은 유지.

암 2 드라이버

[BLOCKED 보류: 충전기 종류]

JETSON Orin Nano Super

USB: 카메라는 젯슨에 직접 연결

배터리 원전압 (10.0-14.6 V)
안정화 12.0 V (서보 최대 12.6 V)
USB 데이터
보호 / 비상정지 제어
실선 테두리 = V1 기존 부품
점선 테두리 = 제안 PROPOSED (미구매 / 미검증)
빨간 점선 = 보류 BLOCKED (하드웨어 확인 필요)

USB 허브 1 (5 V 입력)
[BLOCKED 보류: 입력 전압 미확인]

USB 허브 2 (5 V 입력)
[BLOCKED 보류: 기록에 없음]

모든 (-)선은 각각 배터리 (-)의 POWER_GND
공통점(음극 버스바)에 따로 연결.
