incom8134-web/Kiro_wiring/images/old_versions/KIRO_FINAL_schematic.pdf

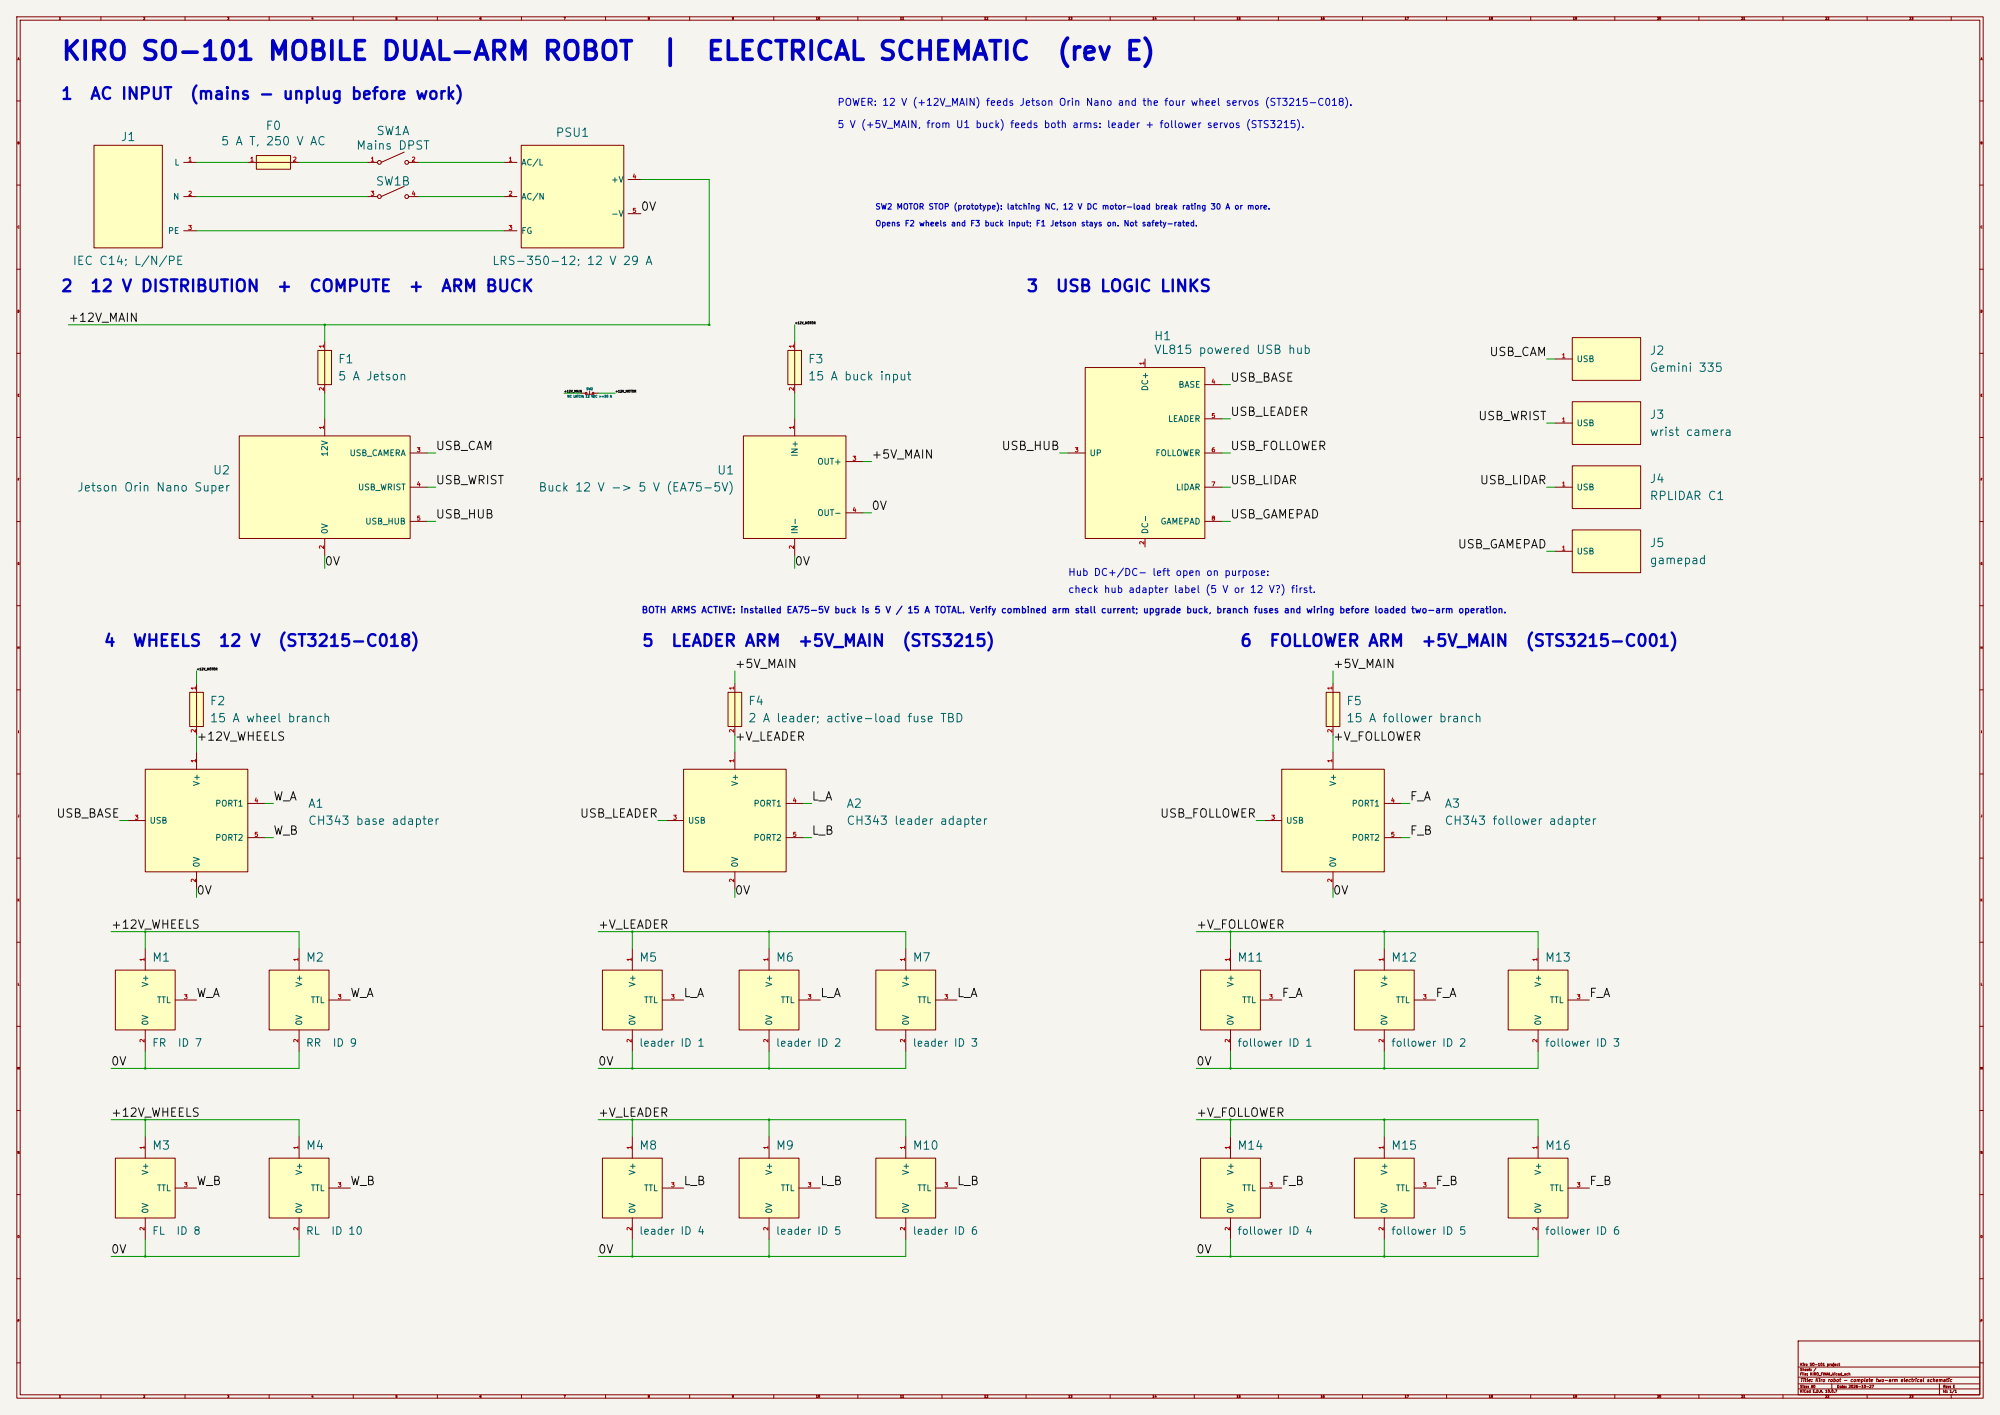
[picture p38: page 1]

KIRO SO-101 MOBILE DUAL-ARM ROBOT | ELECTRICAL SCHEMATIC (rev E)

1 AC INPUT (mains - unplug before work)

POWER: 12 V (+12V_MAIN) feeds Jetson Orin Nano and the four wheel servos (ST3215-C018).

5 V (+5V_MAIN, from U1 buck) feeds both arms: leader + follower servos (STS3215).

SW2 MOTOR STOP (prototype): latching NC, 12 V DC motor-load break rating 30 A or more.
Opens F2 wheels and F3 buck input; F1 Jetson stays on. Not safety-rated.

IEC C14; L/N/PE
2 12 V DISTRIBUTION + COMPUTE + ARM BUCK

Kiro SO-101 project IN+

Jetson Orin Nano Super

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

BOTH ARMS ACTIVE: installed EA75-5V buck is 5 V / 15 A TOTAL. Verify combined arm stall current; upgrade buck, branch fuses and wiring before loaded two-arm operation.

Sheet: /
File: KIRO_FINAL.kicad_sch
Title: Kiro robot - complete two-arm electrical schematic

Size: A0 | Rev: E
KiCad E.D.A. 10.0.7 | Id: 1/1
