incom8134-web/Kiro_wiring/kiro-wiring-2/archive/flat-v2-2026-11-12/exports/KIRO_V2.pdf

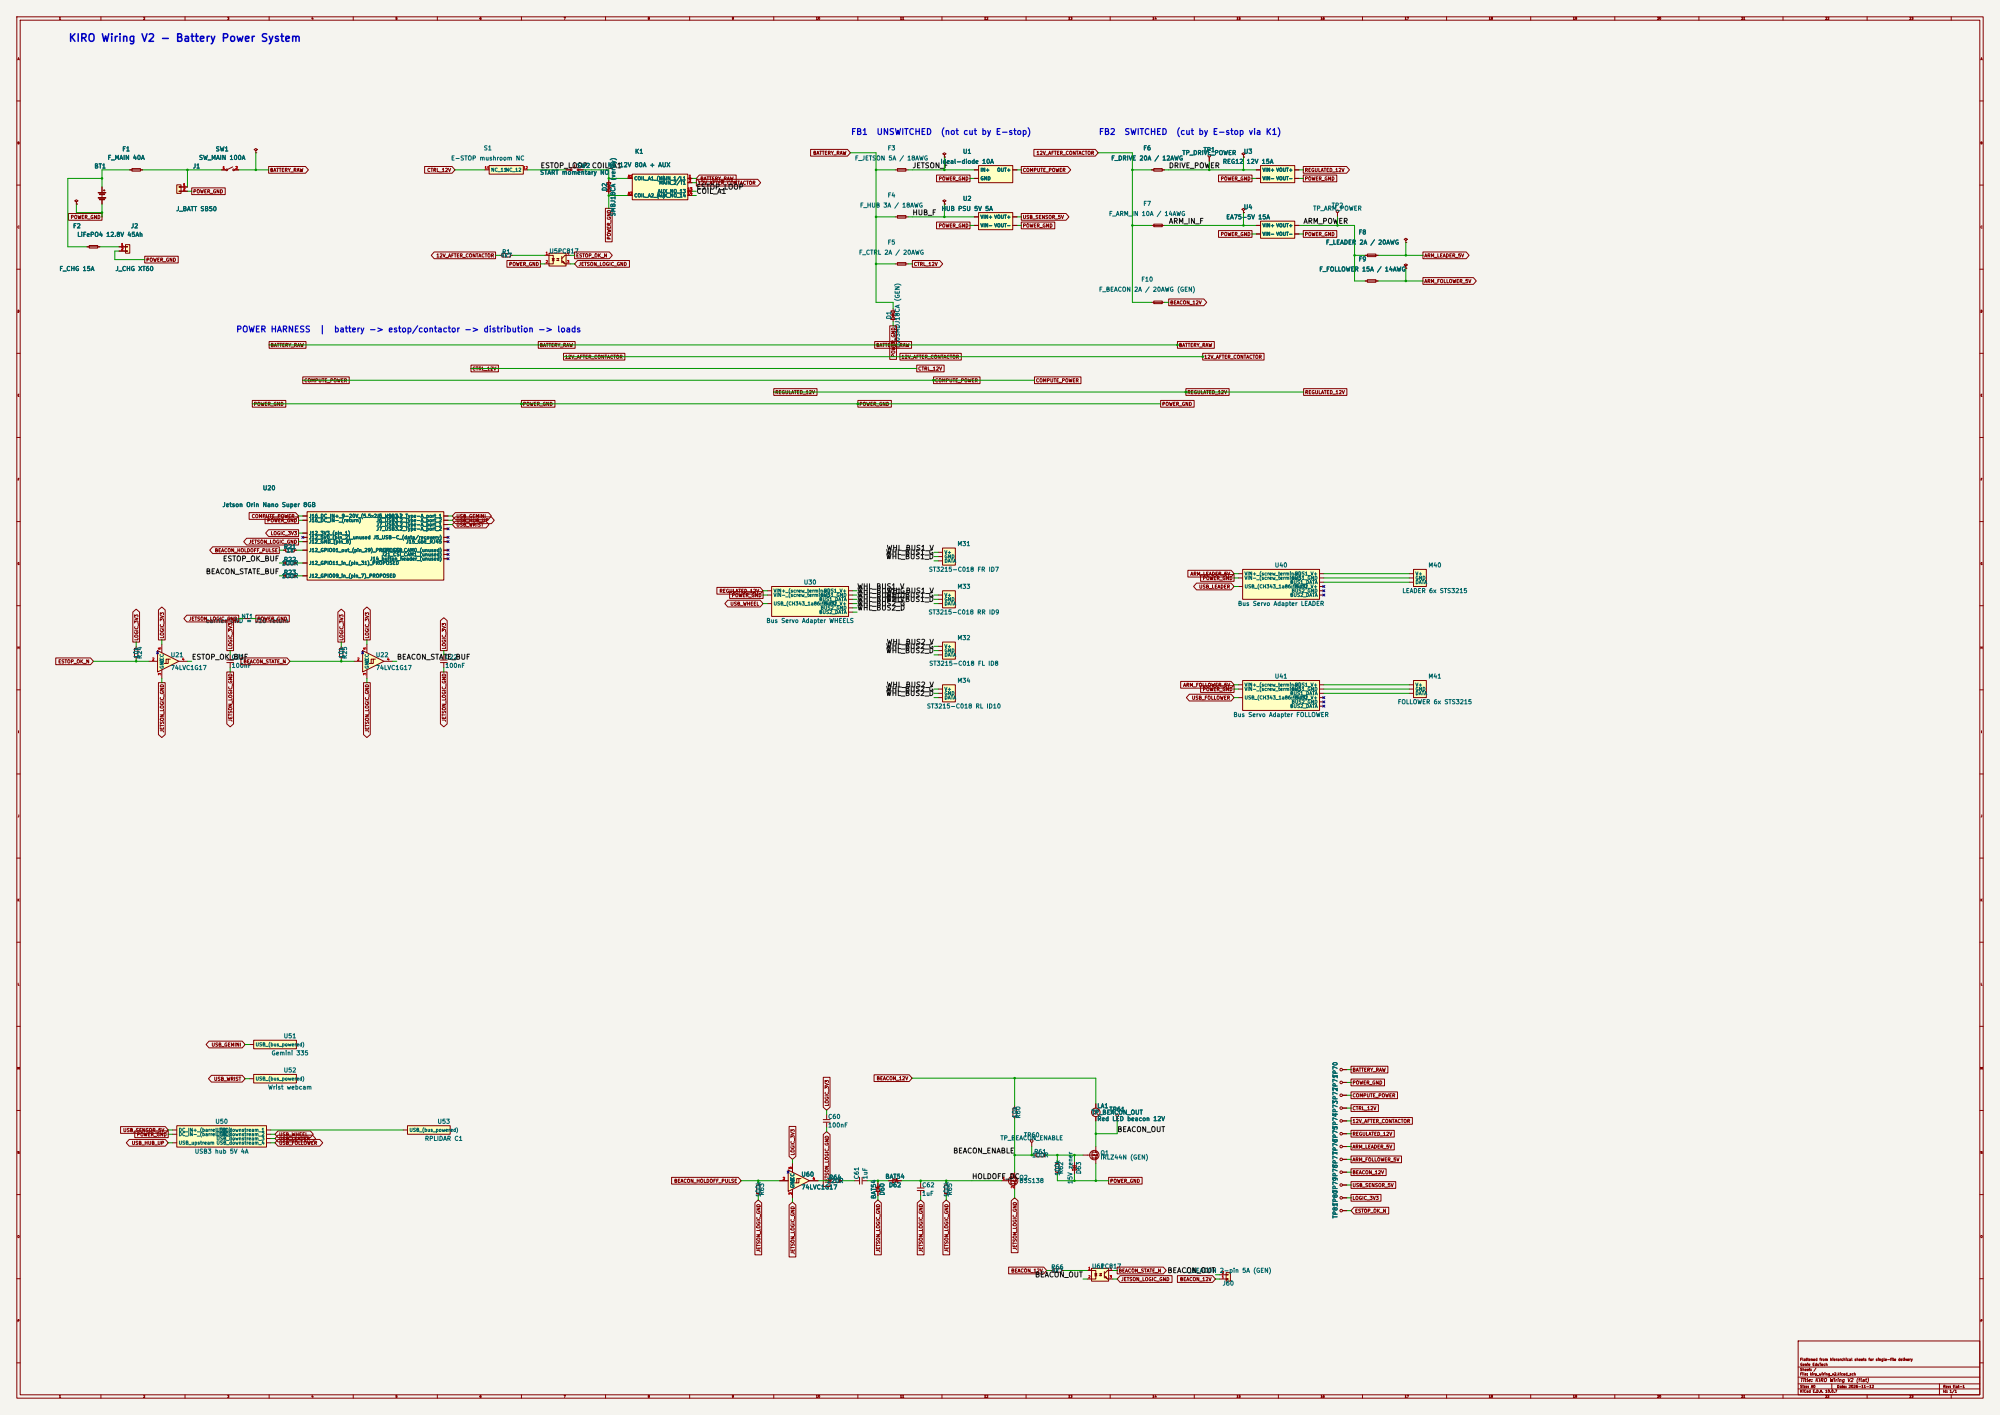
[picture p39: page 1]

KIRO Wiring V2 - Battery Power System

POWER HARNESS | battery -> estop/contactor -> distribution -> loads

Jetson Orin Nano Super 8GB

Bus Servo Adapter LEADER

Bus Servo Adapter WHEELS

Bus Servo Adapter FOLLOWER

Flattened from hierarchical sheets for single-file delivery
Genie EduTech
Sheet: /
File: kiro_wiring_v2.kicad_sch
Title: KIRO Wiring V2 (flat)

Size: A0 | Rev: flat-1
KiCad E.D.A. 10.0.7 | Id: 1/1
