incom8134-web/Kiro_wiring/kiro-wiring-2/kiro_wiring_v2.kicad_sch

## KiCad design kiro-wiring-2/kiro_wiring_v2.kicad_sch (2026-11-12)

Schematic: kiro_wiring_v2.kicad_sch

Parts:
BT1: LiFePO4 12.8V 45Ah (GEN)
C21, C22, C60: 100nF
C61, C62: 1uF
D1: 5.0SMDJ18CA (GEN)
D2: SMBJ18CA (verify)
D60, D62: BAT54
D63: 15V zener
F1: F_MAIN 40A ANL / 8AWG (GEN)
F2: F_CHG 15A (GEN)
F3: F_JETSON 5A / 18AWG
F4: F_HUB 3A / 18AWG
F5: F_CTRL 2A / 20AWG
F6: F_DRIVE 20A / 12AWG
F7: F_ARM_IN 10A / 14AWG
F8: F_LEADER 2A / 20AWG
F9: F_FOLLOWER 15A / 14AWG
F10: F_BEACON 2A / 20AWG (GEN)
J1: J_BATT Anderson SB50 (GEN)
J2: J_CHG XT60 charger inlet (GEN)
J60: J_BEACON 2-pin 5A (GEN)
K1: K1 12V DC contactor 80A + AUX NO (GEN)
LA1: Red 12V LED beacon 5W (GEN)
M31: ST3215-C018 FR ID7
M32: ST3215-C018 FL ID8
M33: ST3215-C018 RR ID9
M34: ST3215-C018 RL ID10
M40: LEADER 6x STS3215 (torque off)
M41: FOLLOWER 6x STS3215 7.4V (GEN)
NT1: carrier GND = J16 return
Q1: IRLZ44N (GEN)
Q2: BSS138; SOT-23
R1, R66: 4k7
R21: 1k
R22, R23, R61: 100R
R24, R25, R60: 10k
R62, R63, R65: 100k
R64: 220R
S1: 22mm mushroom twist-release 1NC (GEN)
SW1: SW_MAIN 100A disconnect (GEN)
SW2: START momentary NO
TP1: TP_DRIVE_POWER
TP2: TP_ARM_POWER
TP60: TP_BEACON_ENABLE
TP61: TP_BEACON_OUT
TP70: TP_BATTERY_RAW
TP71: TP_POWER_GND
TP72: TP_COMPUTE_POWER
TP73: TP_CTRL_12V
TP74: TP_12V_AFTER_CONTACTOR
TP75: TP_REGULATED_12V
TP76: TP_ARM_LEADER_5V
TP77: TP_ARM_FOLLOWER_5V
TP78: TP_BEACON_12V
TP79: TP_USB_SENSOR_5V
TP80: TP_LOGIC_3V3
TP81: TP_ESTOP_OK_N
U1: Ideal-diode LM74700 module 10A (GEN)
U2: HUB PSU 12V->5V 5A buck (GEN)
U3: REG12 12V 15A buck-boost (GEN)
U4: TOBSUN EA75-5V (8-40V in, 5V 15A)
U5, U61: PC817; DIP-4_W7.62mm
U20: Jetson Orin Nano Super Dev Kit 8GB (P3768 carrier)
U21, U22, U60: 74LVC1G17
U30: Bus Servo Adapter (A) CH343 - WHEELS
U40: Bus Servo Adapter (A) CH343 - LEADER
U41: Bus Servo Adapter (A) CH343 - FOLLOWER
U50: Powered 4-port USB3 hub 5V 4A (GEN)
U51: Orbbec Gemini 335 (head)
U52: Suyin HD webcam 1e45:8022 (wrist)
U53: Slamtec RPLIDAR C1 + CP2102N

Connections:
12V_AFTER_CONTACTOR: F6.1, F7.1, F10.1, K1.2 (MAIN_2/T1), R1.1, TP74.1
ARM_FOLLOWER_5V: F9.2, TP77.1, U41.VIN+ (VIN+_(screw_terminal))
ARM_IN_F: F7.2, U4.VIN+
ARM_LEADER_5V: F8.2, TP76.1, U40.VIN+ (VIN+_(screw_terminal))
ARM_POWER: F8.1, F9.1, TP2.1, U4.VOUT+
BATTERY_RAW: D1.2 (A2), F3.1, F4.1, F5.1, K1.1 (MAIN_1/L1), SW1.2 (B), TP70.1
BEACON_12V: F10.2, J60.1, LA1.2 (+), R60.1, R66.1, TP78.1
BEACON_ENABLE: Q2.3 (D), R60.2, R61.1, TP60.1
BEACON_HOLDOFF_PULSE: R21.1, R63.1, U60.2
BEACON_OUT: J60.2, LA1.1 (-), Q1.D, TP61.1, U61.2
BEACON_STATE_BUF: R23.1, U22.4
BEACON_STATE_N: R25.2, U22.2, U61.4
COIL_A1: D2.2 (A2), K1.14 (AUX_NO_14), K1.A1 (COIL_A1_(+)), SW2.2
COMPUTE_POWER: TP72.1, U1.OUT+, U20.J16+ (J16_DC_IN+_9-20V_(5.5x2.5,_ctr_+))
CTRL_12V: F5.2, S1.11 (NC_11), TP73.1
DRIVE_POWER: F6.2, TP1.1, U3.VIN+
ESTOP_LOOP: K1.13 (AUX_NO_13), S1.12 (NC_12), SW2.1
ESTOP_OK_BUF: R22.1, U21.4
ESTOP_OK_N: R24.2, TP81.1, U5.4, U21.2
HOLDOFF_DC: C62.1, D62.1 (K), Q2.1 (G), R65.1
HUB_F: F4.2, U2.VIN+
JETSON_F: F3.2, U1.IN+
JETSON_LOGIC_GND: C21.2, C22.2, C60.2, C62.2, D60.2 (A), NT1.1, Q2.2 (S), R63.2, R65.2, U5.3, U20.6 (J12_GND_(pin_6)), U21.3 (GND), U22.3 (GND), U60.3 (GND), U61.3
LOGIC_3V3: C21.1, C22.1, C60.1, R24.1, R25.1, TP80.1, U20.1 (J12_3V3_(pin_1)), U21.5 (VCC), U22.5 (VCC), U60.5 (VCC)
unnamed: BT1.1 (+), F1.1, F2.1
unnamed: C61.1, R64.2
unnamed: C61.2, D60.1 (K), D62.2 (A)
unnamed: D63.1 (K), Q1.G, R61.2, R62.1
unnamed: F1.2, J1.1, SW1.1 (A)
unnamed: F2.2, J2.1
unnamed: M40.G (GND), U40.1G (BUS1_GND)
unnamed: M40.S (DATA), U40.1S (BUS1_DATA)
unnamed: M40.V (V+), U40.1V (BUS1_V+)
unnamed: M41.G (GND), U41.1G (BUS1_GND)
unnamed: M41.S (DATA), U41.1S (BUS1_DATA)
unnamed: M41.V (V+), U41.1V (BUS1_V+)
unnamed: R1.2, U5.1
unnamed: R21.2, U20.29 (J12_GPIO01_out_(pin_29)_PROPOSED)
unnamed: R22.2, U20.31 (J12_GPIO11_in_(pin_31)_PROPOSED)
unnamed: R23.2, U20.7 (J12_GPIO09_in_(pin_7)_PROPOSED)
unnamed: R64.1, U60.4
unnamed: R66.2, U61.1
unnamed: U50.DS1 (USB_downstream_1), U53.USB
POWER_GND: BT1.2 (-), D1.1 (A1), D2.1 (A1), D63.2 (A), J1.2, J2.2, K1.A2 (COIL_A2_(-)), NT1.2, Q1.S, R62.2, TP71.1, U1.GND, U2.VIN-, U2.VOUT-, U3.VIN-, U3.VOUT-, U4.VIN-, U4.VOUT-, U5.2, U20.J16- (J16_DC_IN-_(return)), U30.VIN- (VIN-_(screw_terminal)), U40.VIN- (VIN-_(screw_terminal)), U41.VIN- (VIN-_(screw_terminal)), U50.DC- (DC_IN-_(barrel_TBD))
REGULATED_12V: TP75.1, U3.VOUT+, U30.VIN+ (VIN+_(screw_terminal))
USB_FOLLOWER: U41.USB (USB_(CH343_1a86:55d3)), U50.DS4 (USB_downstream_4)
USB_GEMINI: U20.J6.1 (J6_USB3.2_Type-A_port_1), U51.USB
USB_HUB_UP: U20.J6.2 (J6_USB3.2_Type-A_port_2), U50.UP (USB_upstream)
USB_LEADER: U40.USB (USB_(CH343_1a86:55d3)), U50.DS3 (USB_downstream_3)
USB_SENSOR_5V: TP79.1, U2.VOUT+, U50.DC+ (DC_IN+_(barrel_TBD))
USB_WHEEL: U30.USB (USB_(CH343_1a86:55d3)), U50.DS2 (USB_downstream_2)
USB_WRIST: U20.J7.1 (J7_USB3.2_Type-A_port_1), U52.USB
WHL_BUS1_D: M31.S (DATA), M33.S (DATA), U30.1S (BUS1_DATA)
WHL_BUS1_G: M31.G (GND), M33.G (GND), U30.1G (BUS1_GND)
WHL_BUS1_V: M31.V (V+), M33.V (V+), U30.1V (BUS1_V+)
WHL_BUS2_D: M32.S (DATA), M34.S (DATA), U30.2S (BUS2_DATA)
WHL_BUS2_G: M32.G (GND), M34.G (GND), U30.2G (BUS2_GND)
WHL_BUS2_V: M32.V (V+), M34.V (V+), U30.2V (BUS2_V+)

Notes on the sheet:
CHARGE-PUMP WATCHDOG (estimate, verify on bench)
GENERIC: E-stop 1NC block 11-12; K1 12 V coil <= 1.5 A, main 80 A DC, AUX NO 13-14. Replace with real part data.
Power Distribution
Reverse polarity: J_BATT must be keyed; compute branch adds an ideal-diode stage (Power_Distribution).
LiDAR start-up (V1): plug sensor cable into adapter with USB unplugged, then connect USB. Motor spin-up after host opens port.
USB PORT ASSIGNMENT
Pull-up and 74LVC1G17 buffer: Jetson_and_GPIO sheet.
FB2 SWITCHED (cut by E-stop via K1)
RPLIDAR C1 | 5 V via USB | 230 mA typ, peak TBD | UART 460800 inside, USB outside (CP2102N) | hub DS1
LEADER: F_LEADER 2 A, 20 AWG. Torque off (hand-guided). ~0.2 A typ, < 1 A peak (V1-doc). After K1 as requested.
R63 100k (> 50k rule): pin floats at boot -> buffer input low -> no pulses -> light ON while armed (fail-safe).
Light OFF only while the heartbeat thread toggles GPIO01 (J12 pin 29) at >= 100 Hz square wave. Frozen, crashed, booting or powered-off Jetson = light ON (if armed).
Current: idle ~1.2 A total, design 6 A, all four stalled 10.8 A (2.7 A each). Feed 14 AWG to screw terminal; 20 AWG servo leads.
Feedback U61: LED across the lamp. Lamp energised -> BEACON_STATE_N LOW. Confirms drive, not filament - check lamp at bring-up.
Pulses stop (either level) -> C62 bleeds through R65: tau = 100k x 1uF = 0.1 s -> Q2 off within ~0.1-0.15 s -> R60 pulls gate up -> light on.
NVIDIA Jetson Orin Nano Super Developer Kit, reference carrier: J16 DC jack, J12 40-pin header, J6/J7 USB
External pull-ups/pull-downs on these pins must be > 50 kOhm. Never load a J12 pin directly.
Hub DC in 5.5 x 2.1 mm, centre +, 5 V 4 A ........ GEN
Adapter feed via screw terminal. Vendor nominal input 9-12.6 V; V1 runs these adapters from 5 V successfully (V1-measured) - keep, verify.
Therefore every GPIO here meets a 74LVC1G17 buffer (CMOS input, push-pull output).
Hard-wired self-holding contactor loop. No software in the safety path.
KIRO Wiring V2 | USB_Hubs_Cameras_and_LiDAR
Test-point panel on every cross-sheet rail, plus the connector schedule
All J12 signals 3.3 V. Non-I2C pins go through TI TXB0108 level translators: drive only +/-20 uA.
Connectors and Test Points
Charger ........ LiFePO4 14.6 V 10 A (GEN)
J_CHG (J2) XT60 charger inlet ...................... GEN
4. TVS_BUS 18 V stand-off: above LiFePO4 14.6 V charge voltage (GEN - recheck if chemistry differs).
7. HUB PSU stays on the unswitched side so cameras, LiDAR and adapter logic keep working after an E-stop.
8. #FLG = ERC power flags only (rail enters through a passive fuse). Not physical parts.
LeRobot leader + follower arms, each on its own CH343 bus adapter and its own fused 5 V branch
E-stop: K1 removes REGULATED_12V -> servos unpowered, no holding torque, robot coasts. Speed feedback over bus = ROBOT_MOVING.
POWER_GND star point = battery negative stud
Hub barrel: if the real hub is 3.5x1.35 or 5.5x2.5 mm, change the plug; never trust "5 mm" alone.
Data: half-duplex TTL 1 Mbps. USB_WHEEL via powered hub. Servo GND returns to the adapter, never through the USB cable shield.
Servo bus Molex 5264 3-pin, use factory servo leads
4 x Feetech/Waveshare ST3215-C018 smart serial servos on one CH343 bus adapter (no generic motor driver)
Jetson and GPIO
J16 Jetson 5.5 x 2.5 mm barrel, centre +, 3.5 A max . NVIDIA spec
Chain 1 (BUS1): adapter -> FR ID7 -> RR ID9. Chain 2 (BUS2): adapter -> FL ID8 -> RL ID10. Max two servos per Molex 5264 contact (~3 A).
Energy 576 Wh nominal; ~461 Wh usable (80 %, estimate)
J7 port 1: Suyin wrist webcam. J7 port 2: spare. Each J6/J7 stack: 3 A VBUS total.
SOFTWARE MEANING: MOTION_WARNING_REQUEST active = stop toggling BEACON_HOLDOFF_PULSE = light ON
Full-charge voltage .. 14.6 V
J16: 9-20 V, 5.5 x 2.5 mm, centre positive, max 3.5 A. Raw battery 10-14.6 V is inside range.
KIRO Wiring V2 | Wheel_Drive
Polarity: generic LED beacon is polar - red wire to J60.1 (+). TVS not required for a lamp/LED load.
6. Arm 5 V rail: EA75-5V as in V1. Follower servo type on V2 (7.4 V or 12 V) is TBD - 5 V is safe for both.
Servo cable: 3-pin Molex 5264 (V+, GND, DATA). Physical pin order: verify against Waveshare ST3215 wiki before crimping (TBD).
KIRO Wiring V2 | Power_Distribution
Pins 29/31/7 are PROPOSED. Pinmux, boot state and state after cleanup: bench-verify (TBD).
Wheel Drive
3. U1 reverse-polarity stage protects the Jetson branch. High-current branches rely on keyed J_BATT + F_MAIN.
Bus 2 of each adapter unused (no-connect). USB to powered hub. Power return by its own wire to the star point.
TEST-POINT USE
K1 main M6 ring lugs, 80 A DC contact ........... GEN
Gate drive ~ BEACON_12V x 100k/110k = 9-13 V. D63 clamps Vgs. Q1: Vds >= 30 V, Id >= 3x lamp current, Rds(on) specified at Vgs = 10 V.
Nominal voltage ...... 12.8 V
Chemistry ........... LiFePO4 4S (GEN)
2. REG12 (REGULATED_12V) is required for lead-acid or LiFePO4: ST3215 limit 12.6 V, raw battery reaches 14.4-14.6 V. Omit only for a 3S Li-ion pack.
KIRO Wiring V2 | Jetson_and_GPIO
R21 1k: GPIO -> buffer input (light sheet). R22/R23 100R: buffer output -> TXB0108 B-side (overdrive).
KIRO Wiring V2 | Safety_EStop_and_Contactor
Press mushroom -> NC 11-12 opens -> coil current stops -> K1 opens -> 12V_AFTER_CONTACTOR = 0 V (wheels, arms, light).
F_MAIN within 150 mm of BT1+. 40 A: above 25.5 A peak load, below 50 A BMS and 8 AWG rating.
Do NOT use hardware PWM for BEACON_HOLDOFF_PULSE: it must stop when software freezes.
GENERIC: lamp 12 V 5 W (~0.42 A). F_BEACON 2 A (LED inrush), 20 AWG, J60 5 A, Q1 IRLZ44N (55 V, Rds 22 mOhm @10 V). Re-check when the lamp is measured.
E-stop: K1 cuts EA75-5V input -> both arms limp. Follower falls under gravity: keep people clear of the arm envelope.
Measure all rails against TP_POWER_GND at the star point. Local TPs:
KIRO Wiring V2 | Battery_and_Charging
4 wait 0.5 s -> 5 forward wheel cmd -> 6 keep light on while any cmd != 0 -> 7 after zero cmd keep on 1.0 s -> 8 resume pulses (light off)
If K1 has no AUX NO: add a 12 V relay, coil parallel to K1 coil, and use its NO contact for the self-hold.
E-STOP BEHAVIOUR
POWER PATH: 12V_AFTER_CONTACTOR -> F_BEACON (Power_Distribution) -> BEACON_12V -> J60.1 -> lamp + ... lamp - -> J60.2 -> Q1 drain -> Q1 source -> POWER_GND
NT1: J12 GND and J16 DC return are the same carrier-board ground. No extra wire to POWER_GND.
Adapter VIN screw terminal (not the 5.5 x 2.1 jack) .. Waveshare
J2/F2: charger joins on the battery side of SW_MAIN, so the robot can charge while switched off.
Battery, main fuse, disconnect, charger inlet and POWER_GND star point
FB1 UNSWITCHED (not cut by E-stop)
TP1 DRIVE_POWER, TP2 ARM_POWER (Power_Distribution); TP60 BEACON_ENABLE,
Broken wire -> pull-up -> HIGH -> software treats as E-stop.
KIRO Wiring V2 | Red_Motion_Warning_Light
Main connector . Anderson SB50, red = + (GEN)
FB1 = unswitched fuse box (compute side) | FB2 = switched fuse box after contactor K1 (actuator side)
Design worst case raw range: 10.0 - 14.6 V
KIRO Wiring V2 | Leader_Follower_Arms
D2 bidirectional TVS clamps coil kick-back without the slow release of a plain flyback diode. Verify vs coil datasheet.
AUX 13-14 = self-hold contact, wired parallel to START
Voltage: V1 follower = 7.4 V STS3215 (trip 8.0 V) -> keep 5 V. A 12 V STS3215 variant would need a new rail (Q2, TBD).
DEVICE TABLE
J6 port 2: powered USB hub upstream (LiDAR + 3x CH343 servo adapters)
ESTOP / START panel wiring, 20 AWG, ferrules ......... GEN
KIRO Wiring V2 | Connectors_and_Test_Points
CONNECTOR SCHEDULE (rating must exceed fuse; pinout verified before crimping)
Leader Follower Arms
J12 HEADER FACTS (NVIDIA carrier spec)
USB hub | DC in 5 V 4 A, barrel 5.5 x 2.1 mm, centre positive (GEN - check against real hub label)
J6 port 1: Orbbec Gemini 335 (USB 3.2 Gen1, bundled cable, never via hub)
Minimum safe voltage . 10.0 V (BMS cut-off)
Supply: REGULATED_12V (ST3215 6-12.6 V; V1 Max_Voltage_Limit 14.0 V). Adapter powered via screw terminal, not its DC jack.
Restart: twist-release mushroom, then press START deliberately. COMPUTE_POWER is upstream of K1: Jetson stays up.
Signal harness J12 pins 1/6/29/31/7 to buffer board, 2.54 mm Dupont, strain-relieved
BATTERY - GENERIC ASSUMPTION (replace with label data)
J_BATT (J1) Anderson SB50, keyed, 50 A ............. GEN
Fail-to-warning: light is ON whenever K1 is closed, unless the Jetson actively holds it OFF with a live pulse train
TP61 BEACON_OUT (Red_Motion_Warning_Light). Strain relief on every harness exit.
Safety EStop and Contactor
Gemini 335 | USB bus 5 V | 896 mA max, <6.5 W | USB 3.2 Gen1 | bundled cable | Jetson J6 port 1 direct
ESTOP_OK_N to Jetson: LOW = 12V_AFTER_CONTACTOR present.
1. Every branch fuse sits in FB1/FB2 at the start of its wire. Wire gauge shown in each fuse value; fuse <= wire and connector rating.
J15 GbE, J5 USB-C, J20/J21 CSI, J14 buttons: present on the carrier, not used in V2 (no-connect).
Shielding: use shielded USB cables; route away from servo and 12 V harnesses. No motor current returns via USB.
BMS ............ 50 A continuous / 100 A peak (GEN)
NOTES
Opto LED on POWER_GND side; transistor on Jetson logic side.
FOLLOWER: F_FOLLOWER 15 A, 14 AWG. ~1-2 A typ, ~6 A design, ~9 A peak at 5 V (V1-doc, verify on V2).
Broken loop wire or blown F_CTRL -> same drop-out. Releasing the mushroom does not re-close K1 (AUX 13-14 open).
Only the installed hub, two cameras and one LiDAR. No other sensors.
5. Pre-charge not fitted: generic REG12 input capacitance is small for an 80 A contactor. Re-check with the real REG12.
USB Hubs Cameras and LiDAR
J_BEACON (J60) 2-pin 5 A, pin 1 = lamp + ............. GEN
SEQUENCE 1 non-zero wheel cmd -> 2 stop pulses (request) -> 3 light on, confirm BEACON_STATE_N low (timeout 0.5 s -> refuse motion, log)
Pulses through C61 and D60/D62 charge C62 to ~2.2-2.5 V -> Q2 on -> BEACON_ENABLE pulled low -> Q1 off -> light off.
Red Motion Warning Light
Wrist webcam | USB bus 5 V | needs 500 mA | USB 2.0 | camera cable | Jetson J7 port 1 direct
Battery and Charging
