incom8134-web/Kiro_wiring/kiro-wiring/kicad/KIRO_FINAL.kicad_sch

## KiCad design kiro-wiring/kicad/KIRO_FINAL.kicad_sch (2026-11-13)

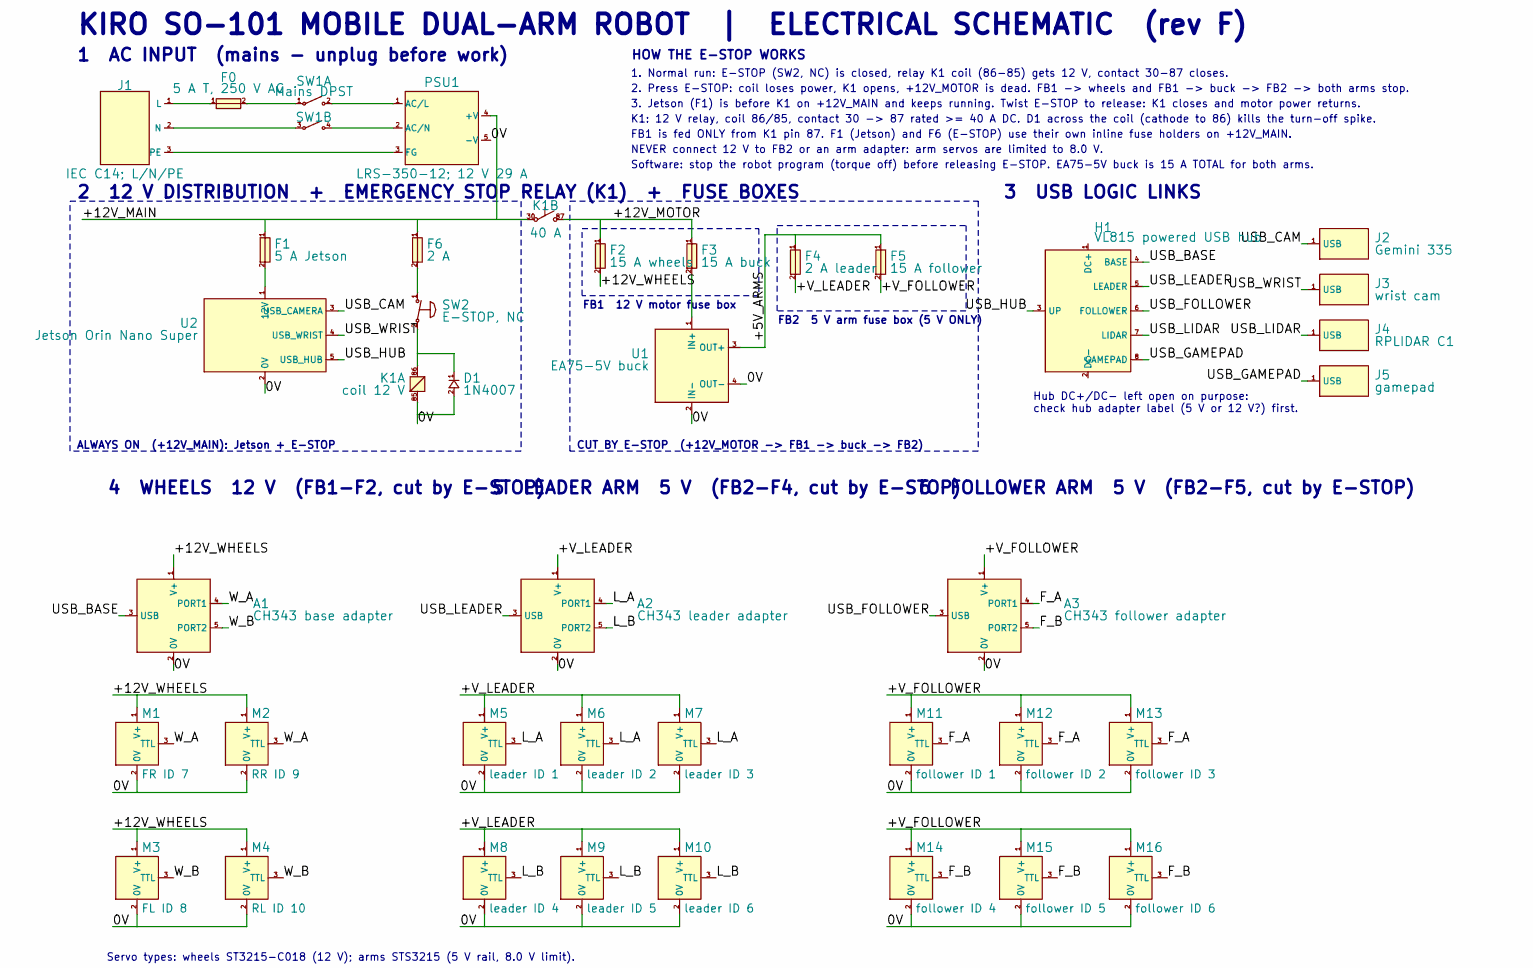
[picture p40: schematic KIRO_FINAL.kicad_sch]

Parts:
A1: CH343 base adapter
A2: CH343 leader adapter
A3: CH343 follower adapter
D1: 1N4007
F0: 5 A T, 250 V AC
F1: 5 A Jetson
F2: 15 A wheels
F3: 15 A buck
F4: 2 A leader
F5: 15 A follower
F6: 2 A
H1: VL815 powered USB hub
J1: IEC C14; L/N/PE
J2: Gemini 335
J3: wrist cam
J4: RPLIDAR C1
J5: gamepad
K1: 40 A
M1: FR ID 7
M2: RR ID 9
M3: FL ID 8
M4: RL ID 10
M5: leader ID 1
M6: leader ID 2
M7: leader ID 3
M8: leader ID 4
M9: leader ID 5
M10: leader ID 6
M11: follower ID 1
M12: follower ID 2
M13: follower ID 3
M14: follower ID 4
M15: follower ID 5
M16: follower ID 6
PSU1: LRS-350-12; 12 V 29 A
SW1: Mains DPST
SW2: E-STOP, NC
U1: EA75-5V buck
U2: Jetson Orin Nano Super

Connections:
0V: A1.2 (0V), A2.2 (0V), A3.2 (0V), D1.2 (A), K1.85, M1.2 (0V), M2.2 (0V), M3.2 (0V), M4.2 (0V), M5.2 (0V), M6.2 (0V), M7.2 (0V), M8.2 (0V), M9.2 (0V), M10.2 (0V), M11.2 (0V), M12.2 (0V), M13.2 (0V), M14.2 (0V), M15.2 (0V), M16.2 (0V), PSU1.5 (-V), U1.2 (IN-), U1.4 (OUT-), U2.2 (0V)
+5V_ARMS: F4.1 (IN), F5.1 (IN), U1.3 (OUT+)
+12V_MAIN: F1.1 (IN), F6.1 (IN), K1.30, PSU1.4 (+V)
+12V_MOTOR: F2.1 (IN), F3.1 (IN), K1.87
+12V_WHEELS: A1.1 (V+), F2.2 (OUT), M1.1 (V+), M2.1 (V+), M3.1 (V+), M4.1 (V+)
+V_FOLLOWER: A3.1 (V+), F5.2 (OUT), M11.1 (V+), M12.1 (V+), M13.1 (V+), M14.1 (V+), M15.1 (V+), M16.1 (V+)
+V_LEADER: A2.1 (V+), F4.2 (OUT), M5.1 (V+), M6.1 (V+), M7.1 (V+), M8.1 (V+), M9.1 (V+), M10.1 (V+)
F_A: A3.4 (PORT1), M11.3 (TTL), M12.3 (TTL), M13.3 (TTL)
F_B: A3.5 (PORT2), M14.3 (TTL), M15.3 (TTL), M16.3 (TTL)
L_A: A2.4 (PORT1), M5.3 (TTL), M6.3 (TTL), M7.3 (TTL)
L_B: A2.5 (PORT2), M8.3 (TTL), M9.3 (TTL), M10.3 (TTL)
unnamed: D1.1 (K), K1.86, SW2.2
unnamed: F0.1, J1.1 (L)
unnamed: F0.2, SW1.1 (L_IN)
unnamed: F1.2 (OUT), U2.1 (12V)
unnamed: F3.2 (OUT), U1.1 (IN+)
unnamed: F6.2 (OUT), SW2.1
unnamed: J1.2 (N), SW1.3 (N_IN)
unnamed: J1.3 (PE), PSU1.3 (FG)
unnamed: PSU1.1 (AC/L), SW1.2 (L_OUT)
unnamed: PSU1.2 (AC/N), SW1.4 (N_OUT)
USB_BASE: A1.3 (USB), H1.4 (BASE)
USB_CAM: J2.1, U2.3 (USB_CAMERA)
USB_FOLLOWER: A3.3 (USB), H1.6 (FOLLOWER)
USB_GAMEPAD: H1.8 (GAMEPAD), J5.1
USB_HUB: H1.3 (UP), U2.5 (USB_HUB)
USB_LEADER: A2.3 (USB), H1.5 (LEADER)
USB_LIDAR: H1.7 (LIDAR), J4.1
USB_WRIST: J3.1, U2.4 (USB_WRIST)
W_A: A1.4 (PORT1), M1.3 (TTL), M2.3 (TTL)
W_B: A1.5 (PORT2), M3.3 (TTL), M4.3 (TTL)

Notes on the sheet:
KIRO SO-101 MOBILE DUAL-ARM ROBOT | ELECTRICAL SCHEMATIC (rev F)
1 AC INPUT (mains - unplug before work)
2 12 V DISTRIBUTION + EMERGENCY STOP RELAY (K1) + FUSE BOXES
ALWAYS ON (+12V_MAIN): Jetson + E-STOP
CUT BY E-STOP (+12V_MOTOR -> FB1 -> buck -> FB2)
FB1 12 V motor fuse box
FB2 5 V arm fuse box (5 V ONLY)
3 USB LOGIC LINKS
Hub DC+/DC- left open on purpose:
check hub adapter label (5 V or 12 V?) first.
4 WHEELS 12 V (FB1-F2, cut by E-STOP)
5 LEADER ARM 5 V (FB2-F4, cut by E-STOP)
6 FOLLOWER ARM 5 V (FB2-F5, cut by E-STOP)
Servo types: wheels ST3215-C018 (12 V); arms STS3215 (5 V rail, 8.0 V limit).
HOW THE E-STOP WORKS
1. Normal run: E-STOP (SW2, NC) is closed, relay K1 coil (86-85) gets 12 V, contact 30-87 closes.
2. Press E-STOP: coil loses power, K1 opens, +12V_MOTOR is dead. FB1 -> wheels and FB1 -> buck -> FB2 -> both arms stop.
3. Jetson (F1) is before K1 on +12V_MAIN and keeps running. Twist E-STOP to release: K1 closes and motor power returns.
K1: 12 V relay, coil 86/85, contact 30 -> 87 rated >= 40 A DC. D1 across the coil (cathode to 86) kills the turn-off spike.
FB1 is fed ONLY from K1 pin 87. F1 (Jetson) and F6 (E-STOP) use their own inline fuse holders on +12V_MAIN.
NEVER connect 12 V to FB2 or an arm adapter: arm servos are limited to 8.0 V.
Software: stop the robot program (torque off) before releasing E-STOP. EA75-5V buck is 15 A TOTAL for both arms.
