incom8134-web/Kiro_wiring/kiro-wiring-2/anker-solix-battery-haebot/kicad/HAEBOT_ANKER.kicad_sch

## KiCad design kiro-wiring-2/anker-solix-battery-haebot/kicad/HAEBOT_ANKER.kicad_sch (2026-11-13)

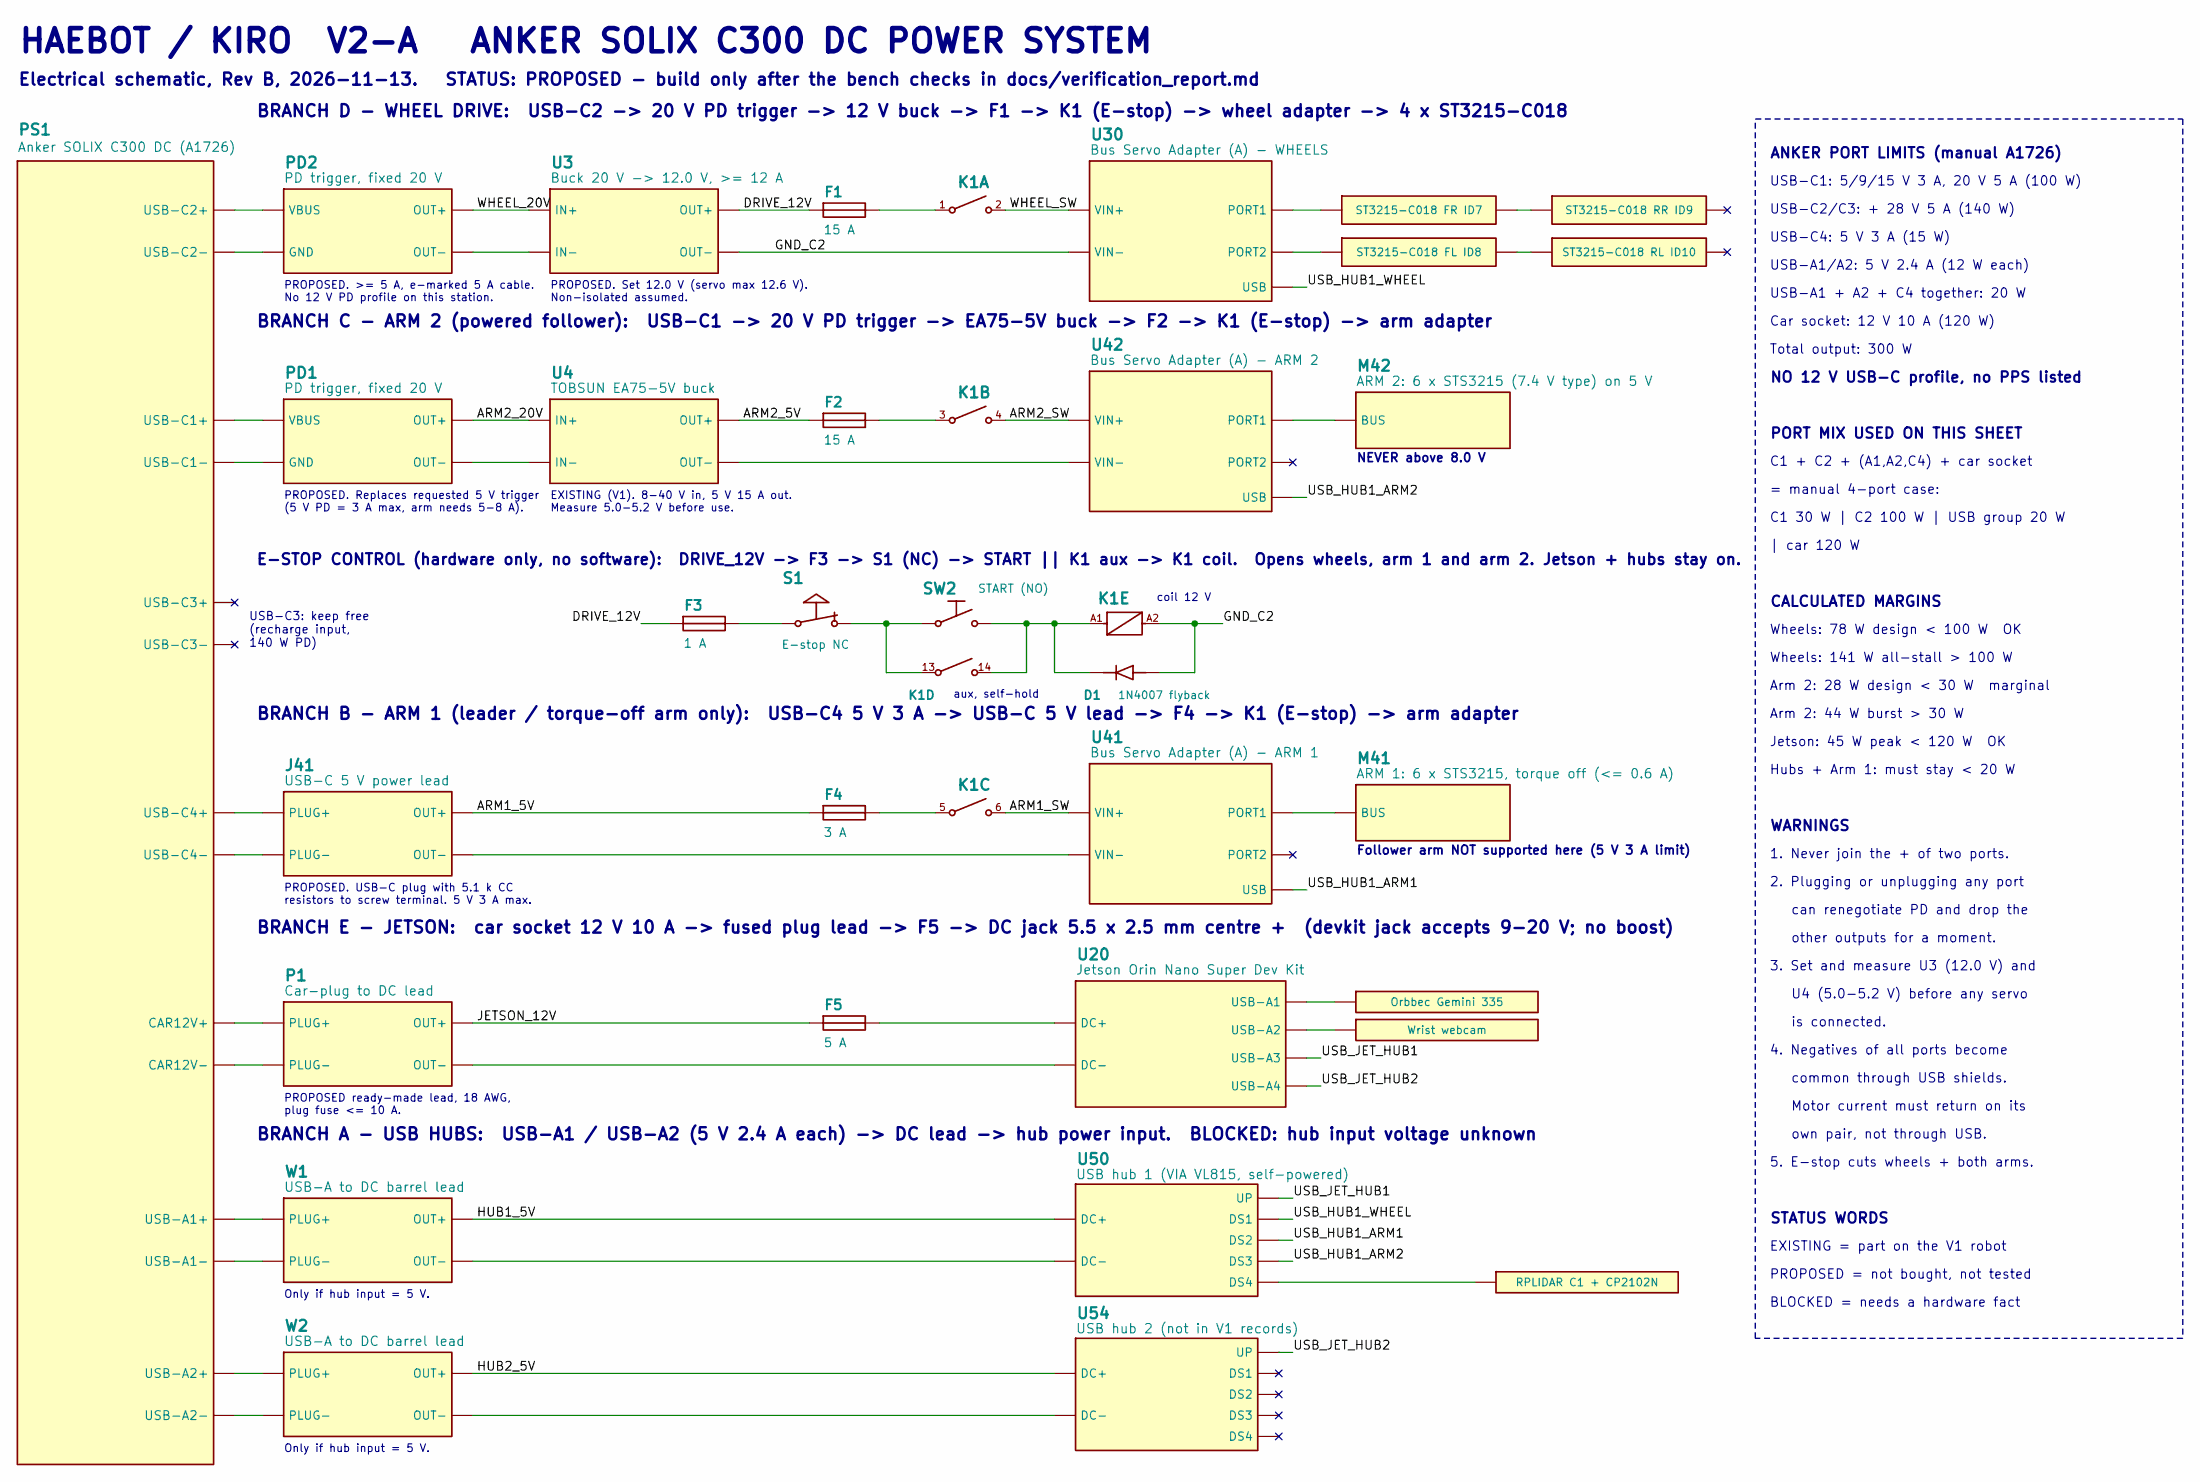
[picture p41: schematic HAEBOT_ANKER.kicad_sch]

Parts:
D1: 1N4007 flyback; Rating 1N4007, cathode to A1
F1, F2: 15 A; Rating 15 A ATO blade, inline holder
F3: 1 A; Rating 1 A, inline
F4: 3 A; Rating 3 A ATO blade, inline holder
F5: 5 A; Rating 5 A, inline
J41: USB-C 5 V power lead; Rating 5 V 3 A
K1: 3-pole 12 V relay/contactor + aux NO; Rating 3 NO power poles >= 20 A each, 12 V DC 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
M31: ST3215-C018 FR ID7; Rating 12 V, stall 2.7 A
M32: ST3215-C018 FL ID8; Rating 12 V, stall 2.7 A
M33: ST3215-C018 RR ID9; Rating 12 V, stall 2.7 A
M34: ST3215-C018 RL ID10; Rating 12 V, stall 2.7 A
M41: ARM 1: 6 x STS3215, torque off (<= 0.6 A); Rating 5 V; 0.3 A design, 0.6 A peak
M42: ARM 2: 6 x STS3215 (7.4 V type) on 5 V; Rating 5 V rail; trips above 8.0 V; 5 A design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
P1: Car-plug to DC lead; Rating 12 V 10 A plug, 18 AWG
PD1: PD trigger, fixed 20 V; Rating 20 V >= 3 A
PD2: PD trigger, fixed 20 V; Rating 20 V 5 A (100 W)
PS1: Anker SOLIX C300 DC (A1726); Rating 288 Wh LiFePO4, 300 W total DC
S1: E-stop NC; Rating 1 NC, twist release
SW2: START (NO); Rating momentary NO
U3: Buck 20 V -> 12.0 V, >= 12 A; Rating in 20 V, out 12.0 V >= 12 A
U4: TOBSUN EA75-5V buck; Rating 8-40 V in, 5 V 15 A 75 W
U20: Jetson Orin Nano Super Dev Kit; Rating DC jack 9-20 V; 25 W typ, 36 W design, 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
U30: Bus Servo Adapter (A) - WHEELS; Rating 9-12.6 V, feed via screw terminal
U41: Bus Servo Adapter (A) - ARM 1; Rating 5 V rail, screw terminal
U42: Bus Servo Adapter (A) - ARM 2; Rating 5 V rail, screw terminal
U50: USB hub 1 (VIA VL815, self-powered); Rating TBD
U51: Orbbec Gemini 335; Rating USB bus powered
U52: Wrist webcam; Rating USB bus powered
U53: RPLIDAR C1 + CP2102N; Rating 5 V 230 mA typ
U54: USB hub 2 (not in V1 records); Rating TBD
W1, W2: USB-A to DC barrel lead; Rating 5 V 2.4 A per USB-A port

Connections:
ARM1_5V: F4.1, J41.3 (OUT+)
ARM1_SW: K1.6 (T), U41.1 (VIN+)
ARM2_5V: F2.1, U4.3 (OUT+)
ARM2_20V: PD1.3 (OUT+), U4.1 (IN+)
ARM2_SW: K1.4 (T), U42.1 (VIN+)
DRIVE_12V: F1.1, F3.1, U3.3 (OUT+)
GND_C2: D1.2, K1.A2, U3.4 (OUT-), U30.2 (VIN-)
HUB1_5V: U50.1 (DC+), W1.3 (OUT+)
HUB2_5V: U54.1 (DC+), W2.3 (OUT+)
JETSON_12V: F5.1, P1.3 (OUT+)
unnamed: D1.1, K1.14, K1.A1, SW2.2
unnamed: F1.2, K1.1 (L)
unnamed: F2.2, K1.3 (L)
unnamed: F3.2, S1.1
unnamed: F4.2, K1.5 (L)
unnamed: F5.2, U20.1 (DC+)
unnamed: J41.1 (PLUG+), PS1.7 (USB-C4+)
unnamed: J41.2 (PLUG-), PS1.8 (USB-C4-)
unnamed: J41.4 (OUT-), U41.2 (VIN-)
unnamed: K1.13, S1.2, SW2.1
unnamed: M31.1, U30.3 (PORT1)
unnamed: M31.2, M33.1
unnamed: M32.1, U30.4 (PORT2)
unnamed: M32.2, M34.1
unnamed: M41.1, U41.3 (PORT1)
unnamed: M42.1, U42.3 (PORT1)
unnamed: P1.1 (PLUG+), PS1.9 (CAR12V+)
unnamed: P1.2 (PLUG-), PS1.10 (CAR12V-)
unnamed: P1.4 (OUT-), U20.2 (DC-)
unnamed: PD1.1 (VBUS), PS1.3 (USB-C1+)
unnamed: PD1.2 (GND), PS1.4 (USB-C1-)
unnamed: PD1.4 (OUT-), U4.2 (IN-)
unnamed: PD2.1 (VBUS), PS1.1 (USB-C2+)
unnamed: PD2.2 (GND), PS1.2 (USB-C2-)
unnamed: PD2.4 (OUT-), U3.2 (IN-)
unnamed: PS1.11 (USB-A1+), W1.1 (PLUG+)
unnamed: PS1.12 (USB-A1-), W1.2 (PLUG-)
unnamed: PS1.13 (USB-A2+), W2.1 (PLUG+)
unnamed: PS1.14 (USB-A2-), W2.2 (PLUG-)
unnamed: U4.4 (OUT-), U42.2 (VIN-)
unnamed: U20.3 (USB-A1), U51.1
unnamed: U20.4 (USB-A2), U52.1
unnamed: U50.2 (DC-), W1.4 (OUT-)
unnamed: U50.7 (DS4), U53.1
unnamed: U54.2 (DC-), W2.4 (OUT-)
USB_HUB1_ARM1: U41.5 (USB), U50.5 (DS2)
USB_HUB1_ARM2: U42.5 (USB), U50.6 (DS3)
USB_HUB1_WHEEL: U30.5 (USB), U50.4 (DS1)
USB_JET_HUB1: U20.5 (USB-A3), U50.3 (UP)
USB_JET_HUB2: U20.6 (USB-A4), U54.3 (UP)
WHEEL_20V: PD2.3 (OUT+), U3.1 (IN+)
WHEEL_SW: K1.2 (T), U30.1 (VIN+)

Notes on the sheet:
USB-C3: keep free (recharge input, 140 W PD)
BRANCH D - WHEEL DRIVE: USB-C2 -> 20 V PD trigger -> 12 V buck -> F1 -> K1 (E-stop) -> wheel adapter -> 4 x ST3215-C018
PROPOSED. >= 5 A, e-marked 5 A cable. No 12 V PD profile on this station.
PROPOSED. Set 12.0 V (servo max 12.6 V). Non-isolated assumed.
BRANCH C - ARM 2 (powered follower): USB-C1 -> 20 V PD trigger -> EA75-5V buck -> F2 -> K1 (E-stop) -> arm adapter
PROPOSED. Replaces requested 5 V trigger (5 V PD = 3 A max, arm needs 5-8 A).
EXISTING (V1). 8-40 V in, 5 V 15 A out. Measure 5.0-5.2 V before use.
NEVER above 8.0 V
E-STOP CONTROL (hardware only, no software): DRIVE_12V -> F3 -> S1 (NC) -> START || K1 aux -> K1 coil. Opens wheels, arm 1 and arm 2. Jetson + hubs stay on.
aux, self-hold
coil 12 V
BRANCH B - ARM 1 (leader / torque-off arm only): USB-C4 5 V 3 A -> USB-C 5 V lead -> F4 -> K1 (E-stop) -> arm adapter
PROPOSED. USB-C plug with 5.1 k CC resistors to screw terminal. 5 V 3 A max.
Follower arm NOT supported here (5 V 3 A limit)
BRANCH E - JETSON: car socket 12 V 10 A -> fused plug lead -> F5 -> DC jack 5.5 x 2.5 mm centre + (devkit jack accepts 9-20 V; no boost)
PROPOSED ready-made lead, 18 AWG, plug fuse <= 10 A.
BRANCH A - USB HUBS: USB-A1 / USB-A2 (5 V 2.4 A each) -> DC lead -> hub power input. BLOCKED: hub input voltage unknown
Only if hub input = 5 V.
HAEBOT / KIRO V2-A ANKER SOLIX C300 DC POWER SYSTEM
Electrical schematic, Rev B, 2026-11-13. STATUS: PROPOSED - build only after the bench checks in docs/verification_report.md
ANKER PORT LIMITS (manual A1726)
USB-C1: 5/9/15 V 3 A, 20 V 5 A (100 W)
USB-C2/C3: + 28 V 5 A (140 W)
USB-C4: 5 V 3 A (15 W)
USB-A1/A2: 5 V 2.4 A (12 W each)
USB-A1 + A2 + C4 together: 20 W
Car socket: 12 V 10 A (120 W)
Total output: 300 W
NO 12 V USB-C profile, no PPS listed
PORT MIX USED ON THIS SHEET
C1 + C2 + (A1,A2,C4) + car socket
= manual 4-port case:
C1 30 W | C2 100 W | USB group 20 W
| car 120 W
CALCULATED MARGINS
Wheels: 78 W design < 100 W OK
Wheels: 141 W all-stall > 100 W
Arm 2: 28 W design < 30 W marginal
Arm 2: 44 W burst > 30 W
Jetson: 45 W peak < 120 W OK
Hubs + Arm 1: must stay < 20 W
WARNINGS
1. Never join the + of two ports.
2. Plugging or unplugging any port
can renegotiate PD and drop the
other outputs for a moment.
3. Set and measure U3 (12.0 V) and
U4 (5.0-5.2 V) before any servo
is connected.
4. Negatives of all ports become
common through USB shields.
Motor current must return on its
own pair, not through USB.
5. E-stop cuts wheels + both arms.
STATUS WORDS
EXISTING = part on the V1 robot
PROPOSED = not bought, not tested
BLOCKED = needs a hardware fact
