incom8134-web/Kiro_wiring/kiro-wiring-2/ev-battery-haebot/kicad/HAEBOT_EV.kicad_sch

## KiCad design kiro-wiring-2/ev-battery-haebot/kicad/HAEBOT_EV.kicad_sch (2026-11-13)

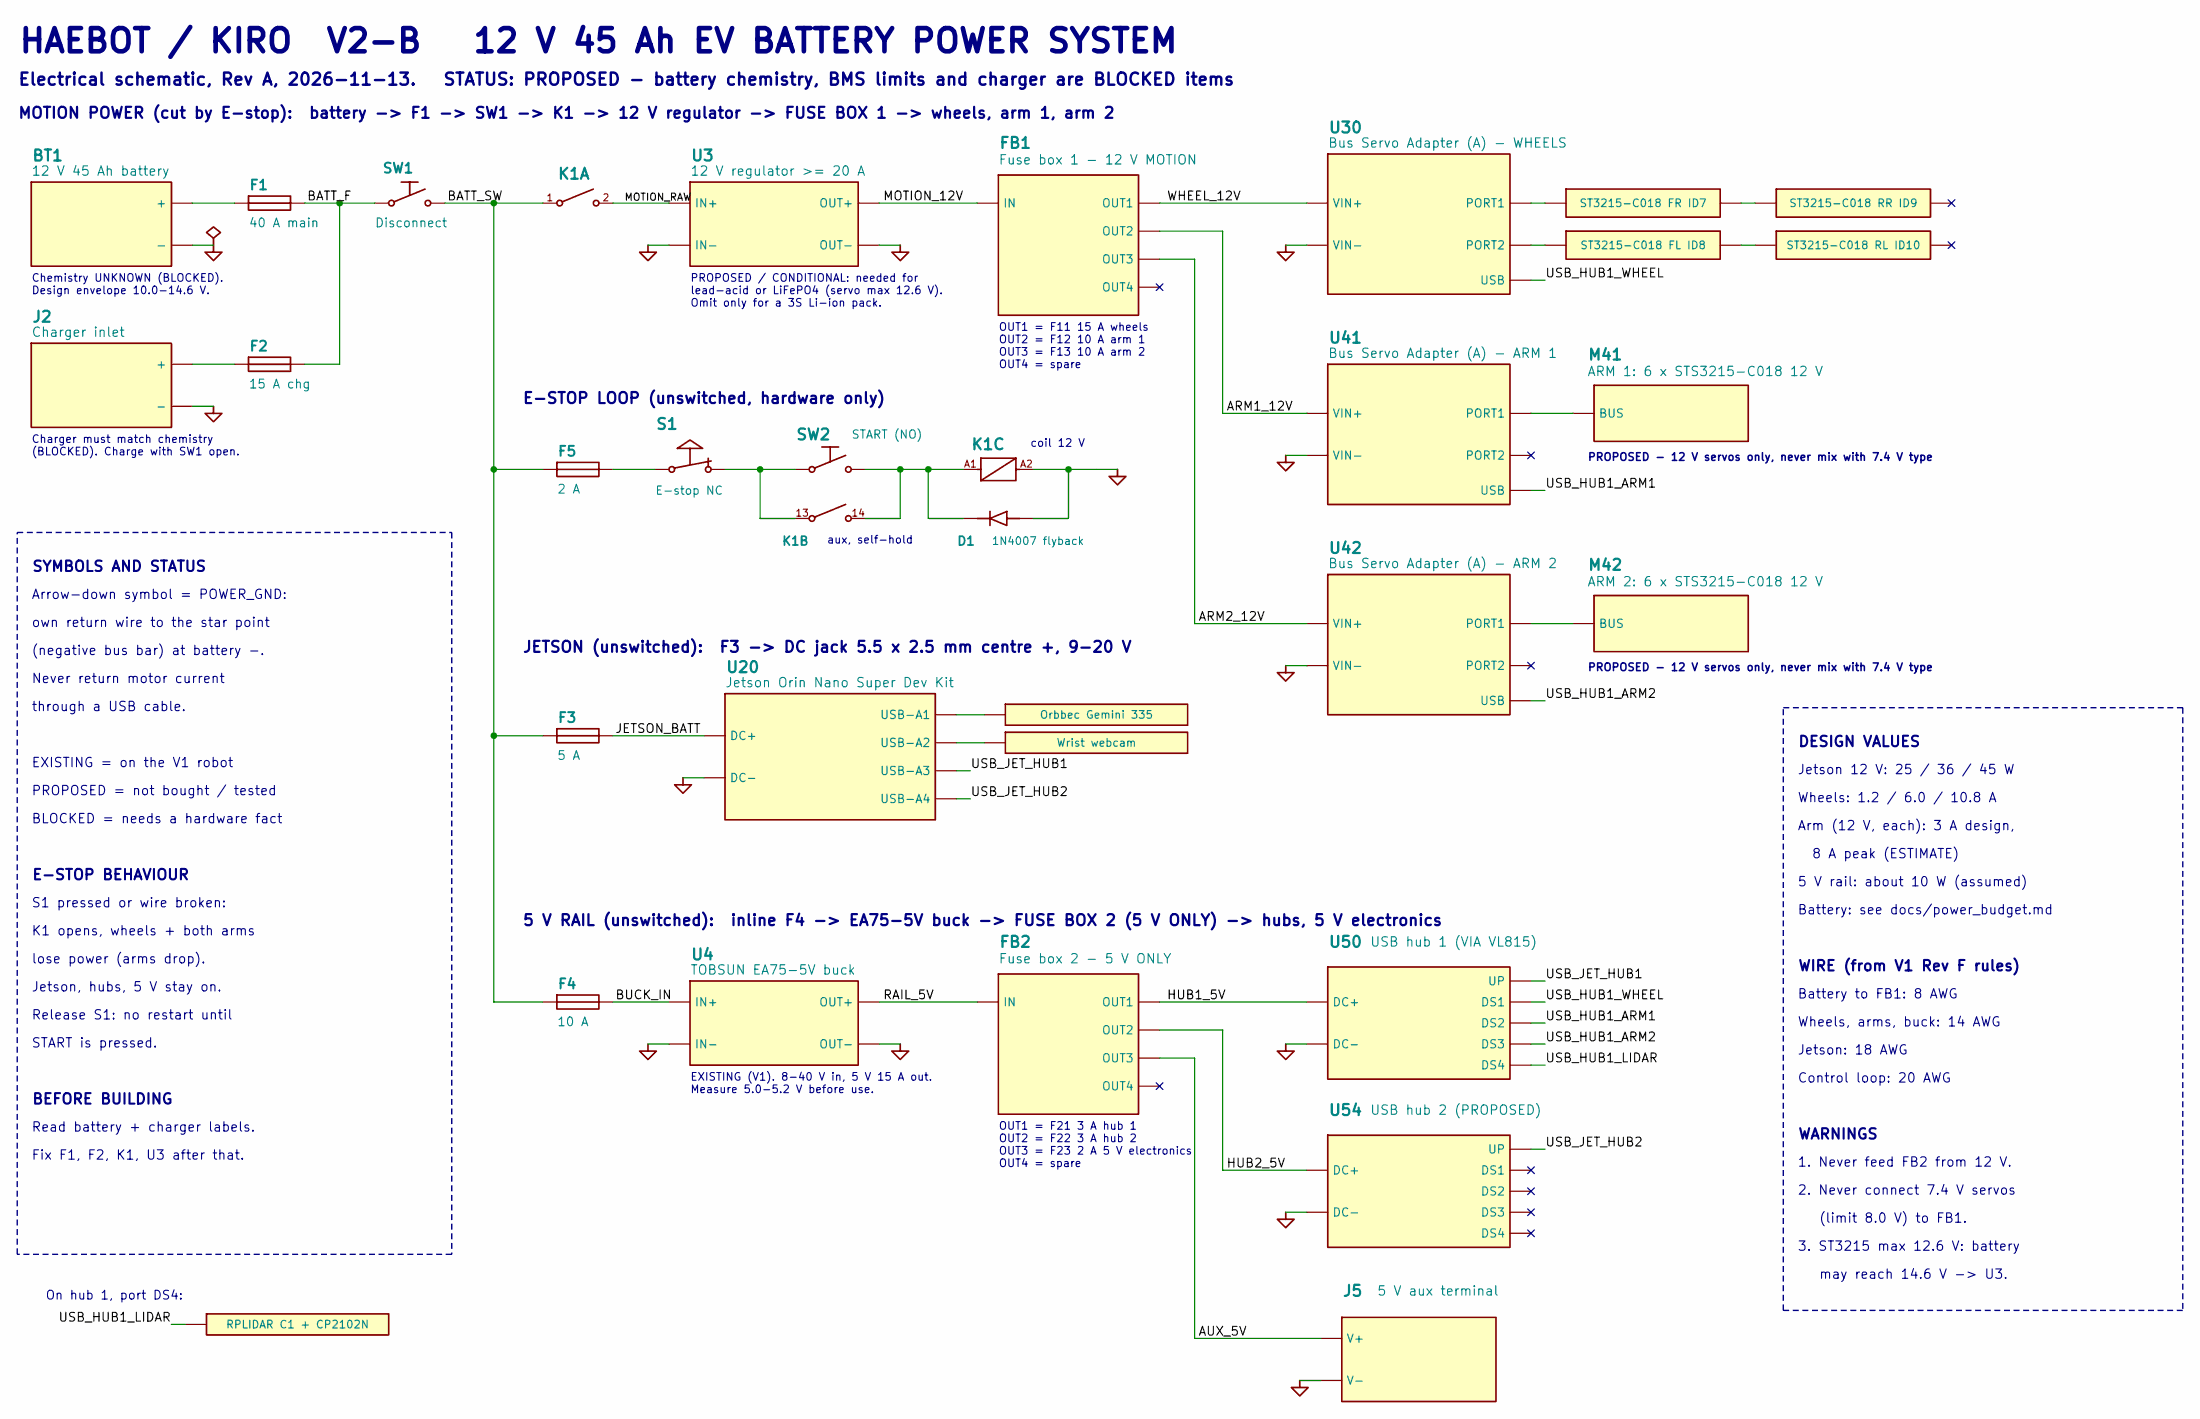
[picture p42: schematic HAEBOT_EV.kicad_sch]

Parts:
BT1: 12 V 45 Ah battery; Rating 12 V nominal 45 Ah (user brief)
D1: 1N4007 flyback; Rating 1N4007, cathode to A1
F1: 40 A main; Rating 40 A ANL/MIDI, <= 150 mm from B+, 8 AWG
F2: 15 A chg; Rating 15 A (final after charger rating)
F3: 5 A; Rating 5 A inline
F4: 10 A; Rating 10 A inline
F5: 2 A; Rating 2 A inline
FB1: Fuse box 1 - 12 V MOTION; Rating 4 x ATO, single live input, no negative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
FB2: Fuse box 2 - 5 V ONLY; Rating 4 x ATO, single live input, no negative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
J2: Charger inlet; Rating TBD by chemistry
J5: 5 V aux terminal; Rating 5 V, fuse 2 A
K1: 12 V DC contactor + aux NO; Rating >= 80 A contacts, 12 V coil, 1 NO aux
M31: ST3215-C018 FR ID7; Rating 12 V (max 12.6 V), stall 2.7 A
M32: ST3215-C018 FL ID8; Rating 12 V (max 12.6 V), stall 2.7 A
M33: ST3215-C018 RR ID9; Rating 12 V (max 12.6 V), stall 2.7 A
M34: ST3215-C018 RL ID10; Rating 12 V (max 12.6 V), stall 2.7 A
M41: ARM 1: 6 x STS3215-C018 12 V; Rating 12 V 30 kg.cm, stall 2.7 A each; arm 3 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
M42: ARM 2: 6 x STS3215-C018 12 V; Rating 12 V 30 kg.cm, stall 2.7 A each; arm 3 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
S1: E-stop NC; Rating 22 mm mushroom, 1 NC, twist release
SW1: Disconnect; Rating >= 100 A DC battery disconnect
SW2: START (NO); Rating momentary NO
U3: 12 V regulator >= 20 A; Rating in 9-16 V, out 12.0 V >= 20 A buck-boost
U4: TOBSUN EA75-5V buck; Rating 8-40 V in, 5 V 15 A 75 W
U20: Jetson Orin Nano Super Dev Kit; Rating DC jack 9-20 V; 25 W typ, 36 W design, 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
U30: Bus Servo Adapter (A) - WHEELS; Rating 9-12.6 V, screw terminal
U41: Bus Servo Adapter (A) - ARM 1; Rating 9-12.6 V, screw terminal
U42: Bus Servo Adapter (A) - ARM 2; Rating 9-12.6 V, screw terminal
U50: USB hub 1 (VIA VL815); Rating TBD - confirm 5 V input on label
U51: Orbbec Gemini 335; Rating USB bus powered
U52: Wrist webcam; Rating USB bus powered
U53: RPLIDAR C1 + CP2102N; Rating 5 V 230 mA typ
U54: USB hub 2 (PROPOSED); Rating TBD

Connections:
ARM1_12V: FB1.2 (OUT2), U41.1 (VIN+)
ARM2_12V: FB1.3 (OUT3), U42.1 (VIN+)
AUX_5V: FB2.3 (OUT3), J5.1 (V+)
BATT_F: F1.2, F2.2, SW1.1
BATT_SW: F3.1, F4.1, F5.1, K1.1 (L), SW1.2
BUCK_IN: F4.2, U4.1 (IN+)
HUB1_5V: FB2.1 (OUT1), U50.1 (DC+)
HUB2_5V: FB2.2 (OUT2), U54.1 (DC+)
JETSON_BATT: F3.2, U20.1 (DC+)
MOTION_12V: FB1.IN, U3.3 (OUT+)
MOTION_RAW: K1.2 (T), U3.1 (IN+)
unnamed: BT1.1 (+), F1.1
unnamed: D1.1, K1.14, K1.A1, SW2.2
unnamed: F2.1, J2.1 (+)
unnamed: F5.2, S1.1
unnamed: K1.13, S1.2, SW2.1
unnamed: M31.1, U30.3 (PORT1)
unnamed: M31.2, M33.1
unnamed: M32.1, U30.4 (PORT2)
unnamed: M32.2, M34.1
unnamed: M41.1, U41.3 (PORT1)
unnamed: M42.1, U42.3 (PORT1)
unnamed: U20.3 (USB-A1), U51.1
unnamed: U20.4 (USB-A2), U52.1
POWER_GND: BT1.2 (-), D1.2, J2.2 (-), J5.2 (V-), K1.A2, U3.2 (IN-), U3.4 (OUT-), U4.2 (IN-), U4.4 (OUT-), U20.2 (DC-), U30.2 (VIN-), U41.2 (VIN-), U42.2 (VIN-), U50.2 (DC-), U54.2 (DC-)
RAIL_5V: FB2.IN, U4.3 (OUT+)
USB_HUB1_ARM1: U41.5 (USB), U50.5 (DS2)
USB_HUB1_ARM2: U42.5 (USB), U50.6 (DS3)
USB_HUB1_LIDAR: U50.7 (DS4), U53.1
USB_HUB1_WHEEL: U30.5 (USB), U50.4 (DS1)
USB_JET_HUB1: U20.5 (USB-A3), U50.3 (UP)
USB_JET_HUB2: U20.6 (USB-A4), U54.3 (UP)
WHEEL_12V: FB1.1 (OUT1), U30.1 (VIN+)

Notes on the sheet:
Chemistry UNKNOWN (BLOCKED). Design envelope 10.0-14.6 V.
Charger must match chemistry (BLOCKED). Charge with SW1 open.
PROPOSED / CONDITIONAL: needed for lead-acid or LiFePO4 (servo max 12.6 V). Omit only for a 3S Li-ion pack.
OUT1 = F11 15 A wheels OUT2 = F12 10 A arm 1 OUT3 = F13 10 A arm 2 OUT4 = spare
PROPOSED - 12 V servos only, never mix with 7.4 V type
E-STOP LOOP (unswitched, hardware only)
aux, self-hold
coil 12 V
JETSON (unswitched): F3 -> DC jack 5.5 x 2.5 mm centre +, 9-20 V
5 V RAIL (unswitched): inline F4 -> EA75-5V buck -> FUSE BOX 2 (5 V ONLY) -> hubs, 5 V electronics
EXISTING (V1). 8-40 V in, 5 V 15 A out. Measure 5.0-5.2 V before use.
OUT1 = F21 3 A hub 1 OUT2 = F22 3 A hub 2 OUT3 = F23 2 A 5 V electronics OUT4 = spare
On hub 1, port DS4:
HAEBOT / KIRO V2-B 12 V 45 Ah EV BATTERY POWER SYSTEM
Electrical schematic, Rev A, 2026-11-13. STATUS: PROPOSED - battery chemistry, BMS limits and charger are BLOCKED items
MOTION POWER (cut by E-stop): battery -> F1 -> SW1 -> K1 -> 12 V regulator -> FUSE BOX 1 -> wheels, arm 1, arm 2
DESIGN VALUES
Jetson 12 V: 25 / 36 / 45 W
Wheels: 1.2 / 6.0 / 10.8 A
Arm (12 V, each): 3 A design,
8 A peak (ESTIMATE)
5 V rail: about 10 W (assumed)
Battery: see docs/power_budget.md
WIRE (from V1 Rev F rules)
Battery to FB1: 8 AWG
Wheels, arms, buck: 14 AWG
Jetson: 18 AWG
Control loop: 20 AWG
WARNINGS
1. Never feed FB2 from 12 V.
2. Never connect 7.4 V servos
(limit 8.0 V) to FB1.
3. ST3215 max 12.6 V: battery
may reach 14.6 V -> U3.
SYMBOLS AND STATUS
Arrow-down symbol = POWER_GND:
own return wire to the star point
(negative bus bar) at battery -.
Never return motor current
through a USB cable.
EXISTING = on the V1 robot
PROPOSED = not bought / tested
BLOCKED = needs a hardware fact
E-STOP BEHAVIOUR
S1 pressed or wire broken:
K1 opens, wheels + both arms
lose power (arms drop).
Jetson, hubs, 5 V stay on.
Release S1: no restart until
START is pressed.
BEFORE BUILDING
Read battery + charger labels.
Fix F1, F2, K1, U3 after that.
