incom8134-web/Kiro_wiring/(commit log)

2026-10-23 Initial commit: Kiro power system design and cart base plate
    - Parametric cart power base plate (CadQuery) with STEP and 3MF exports,
    honeycomb cut-outs, raised SMPS/Jetson mounts, AC inlet tower and
    dovetail split for Bambu Lab P1S printing
    - Design and printing guideline for robot body parts
    - KiCad power schematic and RevA power system design package
    - Software setup demo captures (2026-10-21)
    - Private chat exports excluded via .gitignore
    [KIRO_FINAL.kicad_sch, plate_full.3mf, plate_full.step, plate_left.3mf, plate_left.step, plate_right.3mf, plate_right.step]
2026-10-23 Use two 4-way fuse boxes and add wiring diagram
    - Base plate: replace the 6-way fuse block with two Dorhea 4-way boxes
    (FB1 12 V, FB2 5 V) and add a 0 V ground bus bar pad next to the SMPS
    - Wiring diagram Rev E (PNG + SVG + generator script) with FB1/FB2 and
    the GB1 star-ground bus bar
    - README: wiring section with fuse table, updated component list
    [plate_full.3mf, plate_full.step, plate_left.3mf, plate_left.step, plate_right.3mf, plate_right.step]
2026-10-26 Fit real SMPS, add USB hub tray and combined exports
    - Base plate v3: HS-350-12 SMPS (193 x 100 x 45, fan on top) lying flat on
    four slotted ear riser pads plus support rails; Jetson footprint 100 x 90
    - New USB hub tray for the middle floor (ST Lab hub, ports up, open ends,
    zip-tie flanges), STEP + 3MF
    - export/: combined STEP and OBJ of plate + hub tray, render images
    - Wiring diagram and README updated for the 12 V ~29 A SMPS
    [hub_tray.3mf, hub_tray.step, kiro_power_tray.obj, kiro_power_tray.step, plate_full.3mf, plate_full.step, plate_left.3mf, plate_left.step]
2026-10-26 Lower AC inlet tower to 67 mm total height
    [kiro_power_tray.obj, kiro_power_tray.step, plate_full.3mf, plate_full.step, plate_left.3mf, plate_left.step, plate_right.3mf, plate_right.step]
2026-10-26 AC inlet lower edge at 67 mm above plate (tower 112 mm)
    [kiro_power_tray.obj, kiro_power_tray.step, plate_full.3mf, plate_full.step, plate_left.3mf, plate_left.step, plate_right.3mf, plate_right.step]
2026-10-26 Reorganize repo, drop bus bar, update detailed Blender scene to v3
    - New layout: blender/, cad/{base_plate,usb_hub_tray,assembly}/, electrical/,
    docs/ (step/, print_3mf/, images/ inside each CAD part)
    - Base plate: no ground bus bar (returns go to PSU1 COM / buck OUT-)
    - Wiring diagram Rev F: returns to source, no bus bar
    - Blender scene (5.2) updated from the v2 file: v3 plate, HS-350-12 SMPS
    lying flat on ear pads with top fan, Jetson/fuse boxes shifted, AC inlet at
    67 mm, wires re-routed, detailed ST Lab USB hub in its tray; renders added
    - README rewritten with a "where to find things" map
    [KIRO_FINAL.kicad_sch, KIRO_power_plate.blend, KIRO_power_plate_v2_original.blend, hub_tray.3mf, hub_tray.step, kiro_power_tray.obj, kiro_power_tray.step, plate_full.3mf]
2026-10-26 Add Korean README with language switcher
2026-10-26 Restructure into a clean, flat repository
    - Five top-level folders: images/, docs/, print_files/, 3d_models/, scripts/
    - docs: Rev F power system design and parts list rewritten for the hardware
    on hand (HS-350-12, TOBSUN 5 V buck, 2x Dorhea 4-way, no bus bar);
    outdated RevA Word files and duplicate Markdown removed
    - Removed placeholder renders, the one-piece plate 3MF that does not fit the
    P1S, the v2 Blender archive and the outdated KiCad schematic
    - Scripts write straight into the new folders
    - English and Korean READMEs rewritten around the new layout
    [KIRO_FINAL.kicad_sch, KIRO_power_plate.blend, KIRO_power_plate_v2_original.blend, assembly.obj, assembly.step, base_plate.step, base_plate_left.3mf, base_plate_left.step]
2026-10-26 Keep _local/ out of the repository
    [KIRO_FINAL.kicad_sch]
2026-10-26 Keep only shareable files in the repository
    - Generator scripts and the part-design guideline moved to the local-only
    _local/ folder
    - Print files now live in 3d_models/print_files/
    - Docs and both READMEs updated: no internal references, no script section
    [base_plate_left.3mf, base_plate_right.3mf, usb_hub_tray.3mf]
2026-10-29 Add updated wiring diagrams and KiCad schematic
    [KIRO_FINAL.kicad_sch]
2026-11-11 Add KIRO Wiring V2: battery-powered hierarchical KiCad schematic
    - New KiCad 10 project in kiro_wiring_v2/ (V1 untouched): System_Overview
    plus 9 sheets (battery/charging, power distribution, E-stop + contactor,
    Jetson + GPIO, wheel drive, leader/follower arms, USB/cameras/LiDAR,
    red motion-warning light, connectors + test points)
    - Custom symbol library KIRO_V2.kicad_sym (Jetson Orin Nano devkit,
    CH343 bus servo adapter, ST3215, contactor, E-stop, hub, DC-DC)
    - Hard-wired self-holding E-stop loop; Jetson stays powered upstream of K1
    - J12 GPIO buffered with 74LVC1G17 (TXB0108, +/-20 uA per NVIDIA spec)
    - Fail-to-warning beacon driver with charge-pump heartbeat watchdog
    - Unknown par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
    [Battery_and_Charging.kicad_sch, Connectors_and_Test_Points.kicad_sch, Jetson_and_GPIO.kicad_sch, KIRO_배선도V2_BOM_261111.csv, Leader_Follower_Arms.kicad_sch, Power_Distribution.kicad_sch, Red_Motion_Warning_Light.kicad_sch, Safety_EStop_and_Contactor.kicad_sch]
2026-11-12 Reorganize into kiro-wiring/ and kiro-wiring-2/
    Flatten local KiCad trees to match the clean two-folder layout: v1 schematic+PDF under kiro-wiring/, hierarchical v2 project under kiro-wiring-2/, shared images/docs/3d_models at root. Drop locks/history/.prl junk. Local is source of truth for v2 + PDF exports.
    [Battery_and_Charging.kicad_sch, Connectors_and_Test_Points.kicad_sch, Jetson_and_GPIO.kicad_sch, KIRO_FINAL.kicad_sch, KIRO_배선도V2_BOM_261111.csv, Leader_Follower_Arms.kicad_sch, Power_Distribution.kicad_sch, Red_Motion_Warning_Light.kicad_sch]
2026-11-12 Flatten kiro-wiring-2 to a single schematic + PDF
    Merge hierarchical V2 sheets into one flat kiro_wiring_v2.kicad_sch, drop empty .kicad_pcb and child sheets, refresh KIRO_V2.pdf via KiCad 10 kicad-cli.
    [Battery_and_Charging.kicad_sch, Connectors_and_Test_Points.kicad_sch, Jetson_and_GPIO.kicad_sch, Leader_Follower_Arms.kicad_sch, Power_Distribution.kicad_sch, Red_Motion_Warning_Light.kicad_sch, Safety_EStop_and_Contactor.kicad_sch, USB_Hubs_Cameras_and_LiDAR.kicad_sch]
2026-11-12 Drop kiro-wiring-2 local .kicad_prl junk
2026-11-12 Enlarge schematic text sizes for PDF readability.
    Scale font (size w h) only in both kiro-wiring and kiro-wiring-2
    schematics (~1.5x on V1; 1.27 defaults to 3.0 on V2), then refresh PDFs.
    [KIRO_FINAL.kicad_sch, kiro_wiring_v2.kicad_sch]
2026-11-12 Clean V2 schematic: remove clutter, fix overlapping labels.
    Delete redundant former-sheet titles and long notes, shorten values,
    reposition fields/labels, keep one master title, and refresh KIRO_V2.pdf.
    [kiro_wiring_v2.kicad_sch]
2026-11-12 Reflow V2 into one continuous power-harness schematic.
    [kiro_wiring_v2.kicad_sch]
2026-11-13 Reorganize into V1 + two independent V2 battery designs
    V1 (kiro-wiring/): files moved into kicad/, exports/ and docs/. No electrical
    change. Marked as the legacy AC/SMPS reference.
    V2 (kiro-wiring-2/):
    - anker-solix-battery-haebot/: Anker SOLIX C300 DC (A1726) design, Rev A
    - ev-battery-haebot/: 12 V 45 Ah battery design with 12 V arm servos, Rev A
    Each has a KiCad project, schematic and block-diagram PDFs, netlist, BOM,
    power budget, wiring table, protection notes, verification report, assembly
    instructions and AGENTS.md.
    - exports/HAEBOT_V2_POWER_SYSTEM_COMPARISON.pdf: combined review document
    - archive/flat-v2-2026-11-12/: earlier single-sheet V2 draft, moved unchanged
    - removed kiro-wi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
    [HAEBOT_ANKER.kicad_sch, HAEBOT_ANKER_BOM.csv, HAEBOT_EV.kicad_sch, HAEBOT_EV_BOM.csv, KIRO_FINAL.kicad_sch, KIRO_배선도V2_BOM_261111.csv, kiro_wiring_v2.kicad_sch]
2026-11-13 Anker design Rev B: E-stop also cuts arm 1; Korean block diagram
    - K1 becomes a 3-pole contactor: pole 3 opens the arm 1 (USB-C4) branch, so
    one press of the mushroom button removes power from wheels, arm 1 and arm 2.
    - Schematic, netlist, block diagram, BOM and documents updated to Rev B.
    - Added Korean block diagram (SVG + PDF).
    - Comparison PDF regenerated.
    Claude-Session: https://claude.ai/code/session_01MwwF3Qfd4KFiQxXL81zpf5
    [HAEBOT_ANKER.kicad_sch, HAEBOT_ANKER_BOM.csv]
2026-11-13 Add Korean EV battery block diagram
    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
